LIBREhub/2_Levels_Stage/2-level-station.md

# 2-level microscopy stage

This is a variant of the Strobe-Enhanced Microscope Stage. It is still a laboratory-grade microscope for imaging fast-moving objects.



Before you start building the station you will need to source all the components listed in our [bill of materials]{BOM}.

## Instructions

These instructions will take you through how to assemble the 2-level version of the station. There is also a [3-level version](https://wenzel-lab.github.io/strobe-enhanced-microscopy-stage/) if you need a room for placing your boards and protected them in the station.

The assembly is broken up into several steps:

1. [.](printing.md){step}
1. [.](laser-cutting.md){step}
1. [.](assemble-focus-mechanism.md){step}
1. [.](basic-optics-module.md){step}
1. [.](attach-parts-to-top-plate.md){step}
1. [.](attach-parts-to-bottom-plate.md){step}
1. [.](mount-optics.md){step}
1. [.](illumination.md){step}
1. [.](wiring.md){step}
1. [.](finished.md){step}
