LIBREhub/2_Levels_Stage/info_pages/why_optics_black.html

# Strobe-Enhanced Microscopy Stage

by Pierre Padilla-Huamantinco, Matías Hurtado Labarca, and Tobias Wenzel

Latin American Hub for Bioimaging Through Open Hardware (LIBRE hub)

# Why print the optics module or lens spacer in black?

The optics module or lens spacer is used to separate the imaging optics from the camera sensor. In an ideal microscope the only light that reaches the camera sensor should be the light focused by these optics.

We can limit reflected light using black filament. This will absorb more of the stray light. Black filament is also more opaque than other filaments. This means that less light will be transmitted through the walls of the optics module.

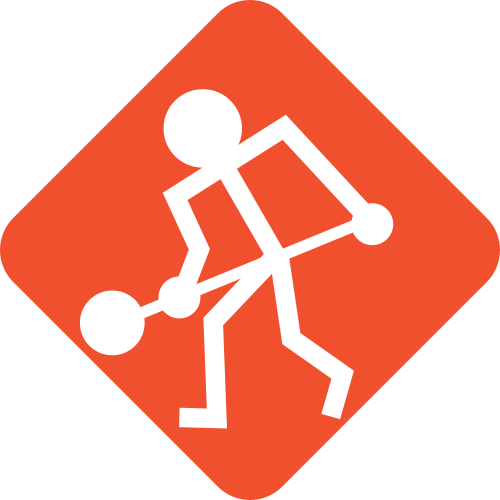
[picture p45: static/Logo/GitBuilding500x.png]
GitBuilding logo
 Documentation powered by GitBuilding (https://gitbuilding.io)

©2023 Pierre Padilla-Huamantinco, Matías Hurtado Labarca, and Tobias Wenzel

Contact: librehub@uc.cl

Strobe-Enhanced Microscopy Stage is released under CERN-OHL-1.2.
