LIBREhub/2_Levels_Stage/parts/optics/8.7-20mm-circular-lens.html

# Strobe-Enhanced Microscopy Stage

by Pierre Padilla-Huamantinco, Matías Hurtado Labarca, and Tobias Wenzel

Latin American Hub for Bioimaging Through Open Hardware (LIBRE hub)

# 8.7° 20mm Circular Beam Optics



Suppliers:

- Luxeonstar / Lens (https://www.luxeonstar.com/carclo-8.7-degree-20mm-optic)
- Luxeonstar / Holder (https://www.luxeonstar.com/carclo-20mm-round-optic-holder-black)

GitBuilding logo Documentation powered by GitBuilding (https://gitbuilding.io)

©2023 Pierre Padilla-Huamantinco, Matías Hurtado Labarca, and Tobias Wenzel

Contact: librehub@uc.cl

Strobe-Enhanced Microscopy Stage is released under CERN-OHL-1.2.
