LIBREhub/2_Levels_Stage/images/bottom_plate_to_focus_1.jpg

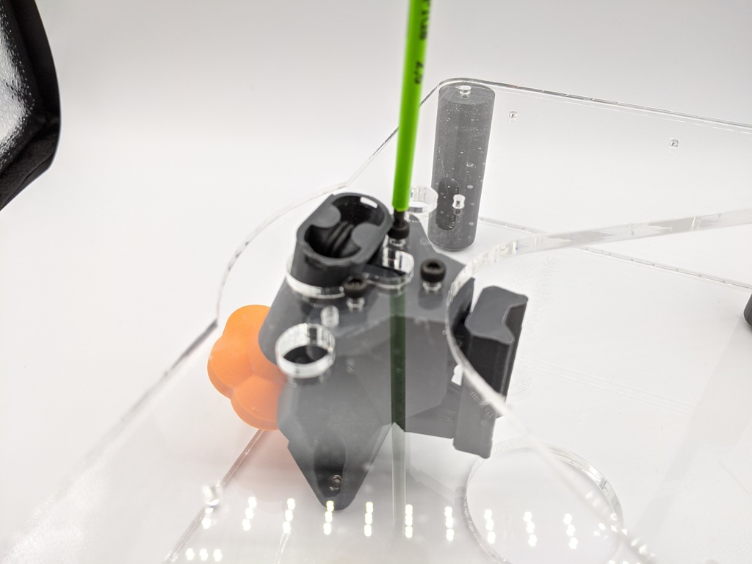
images/bottom_plate_to_focus_1.jpg
