LIBREhub/2_Levels_Stage/images/bottom_plate_to_focus_2.jpg

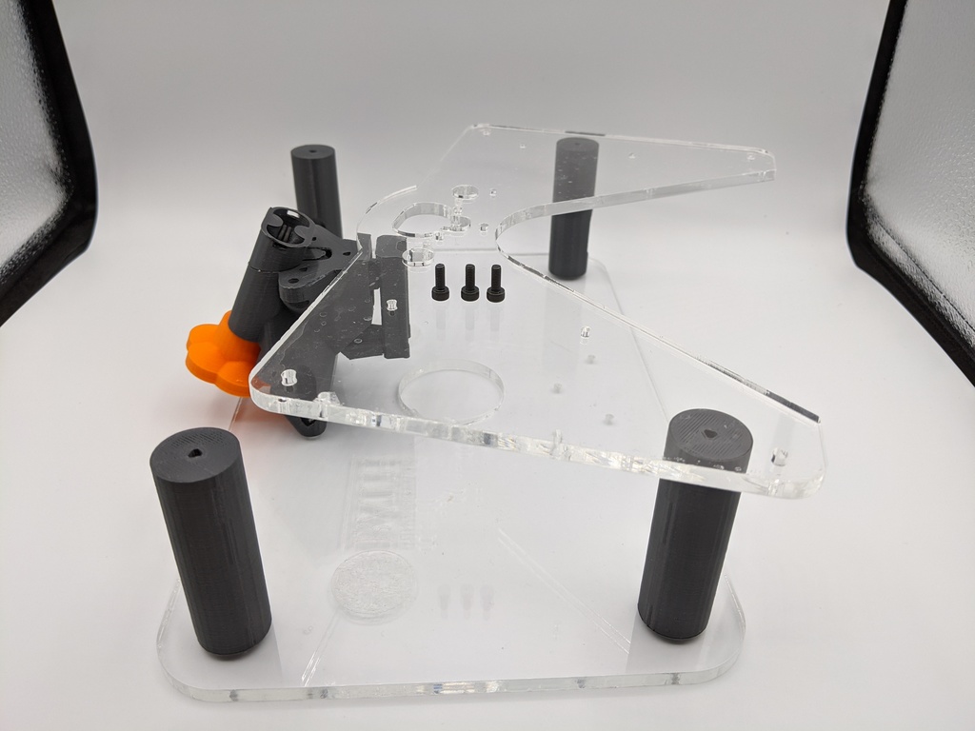
images/bottom_plate_to_focus_2.jpg
