LIBREhub/2_Levels_Stage/images/BrimRemoval.png

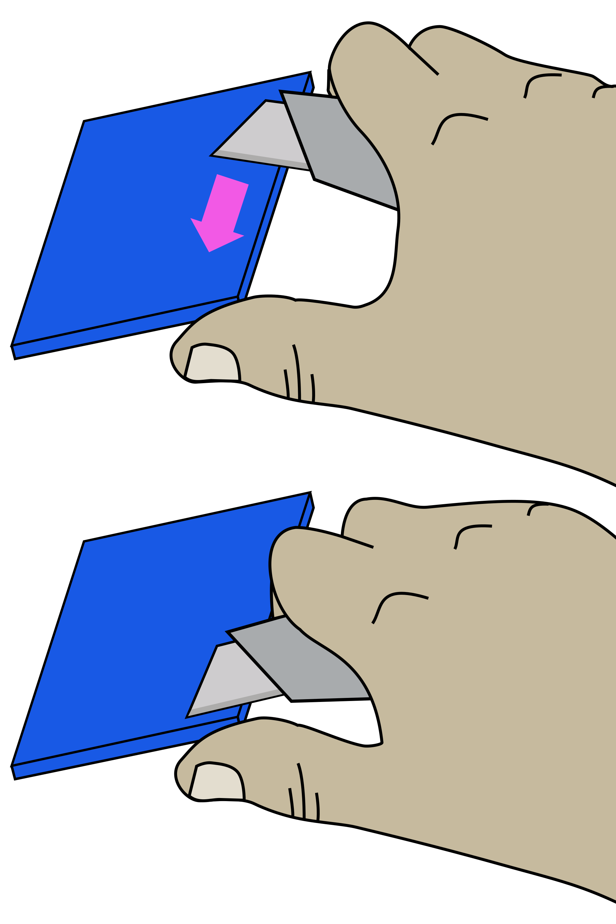
images/BrimRemoval.png
