LIBREhub/2_Levels_Stage/images/cap.jpg

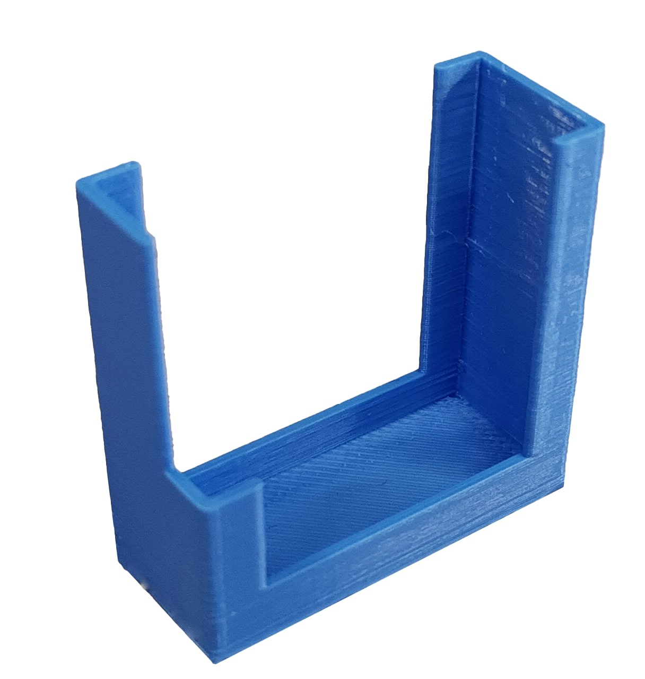
images/cap.jpg
