LIBREhub/2_Levels_Stage/images/Crimper.jpg

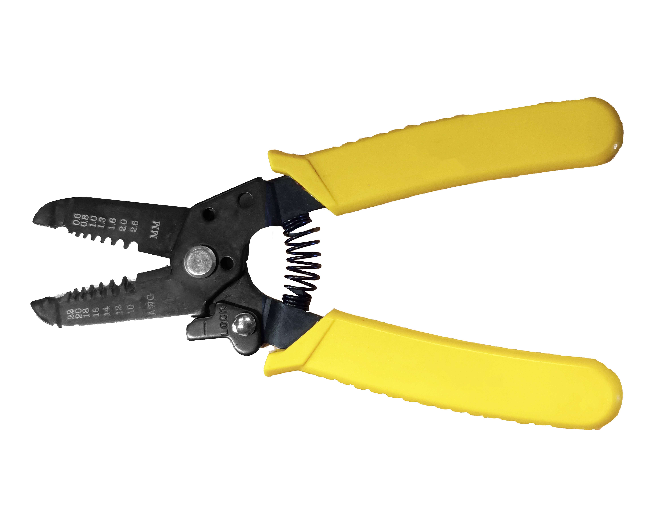
images/Crimper.jpg
