LIBREhub/2_Levels_Stage/images/dupont-housing.jpg

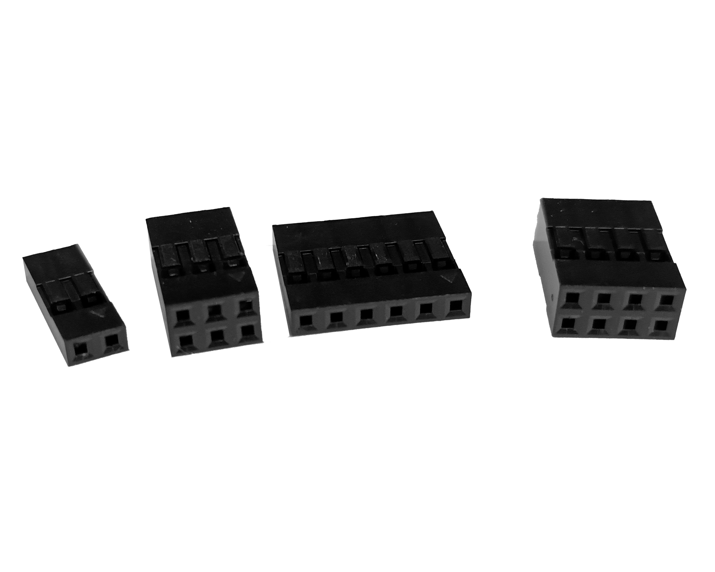
images/dupont-housing.jpg
