LIBREhub/2_Levels_Stage/images/feet-M-attached.jpg

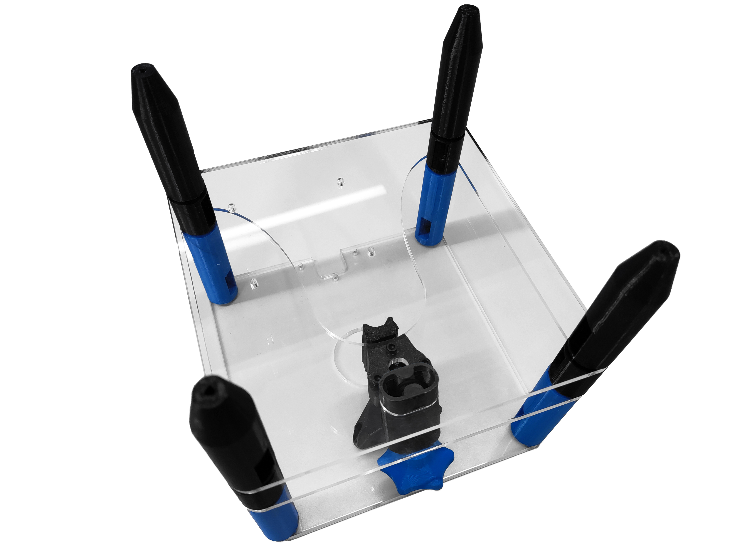
images/feet-M-attached.jpg
