LIBREhub/2_Levels_Stage/images/feet-M-attached_1.jpg

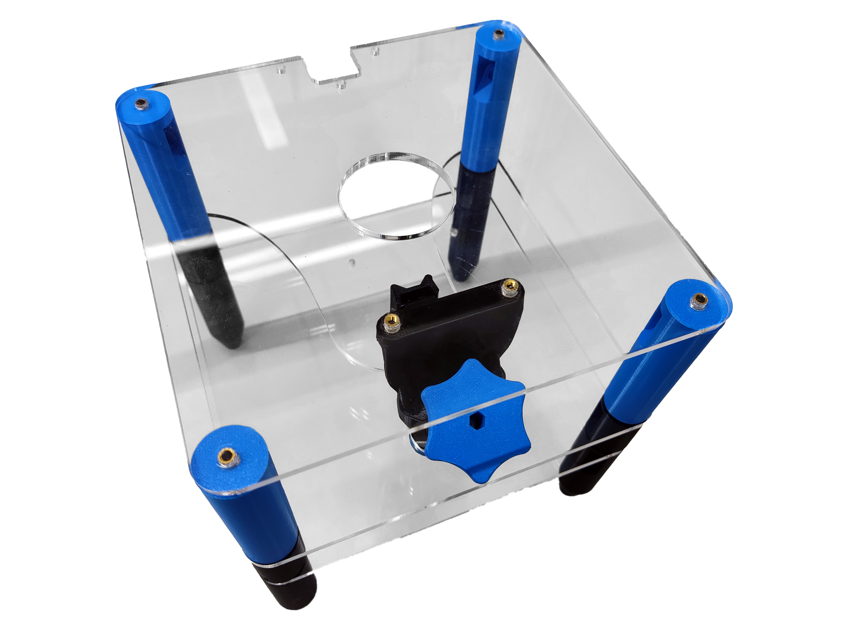
images/feet-M-attached_1.jpg
