LIBREhub/2_Levels_Stage/images/feet_attachment.png

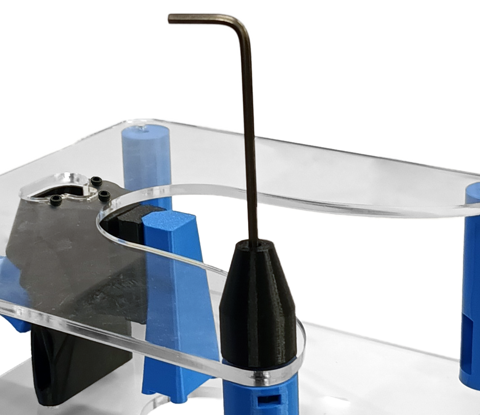
images/feet_attachment.png
