LIBREhub/2_Levels_Stage/images/Female-crimp-pin.jpg

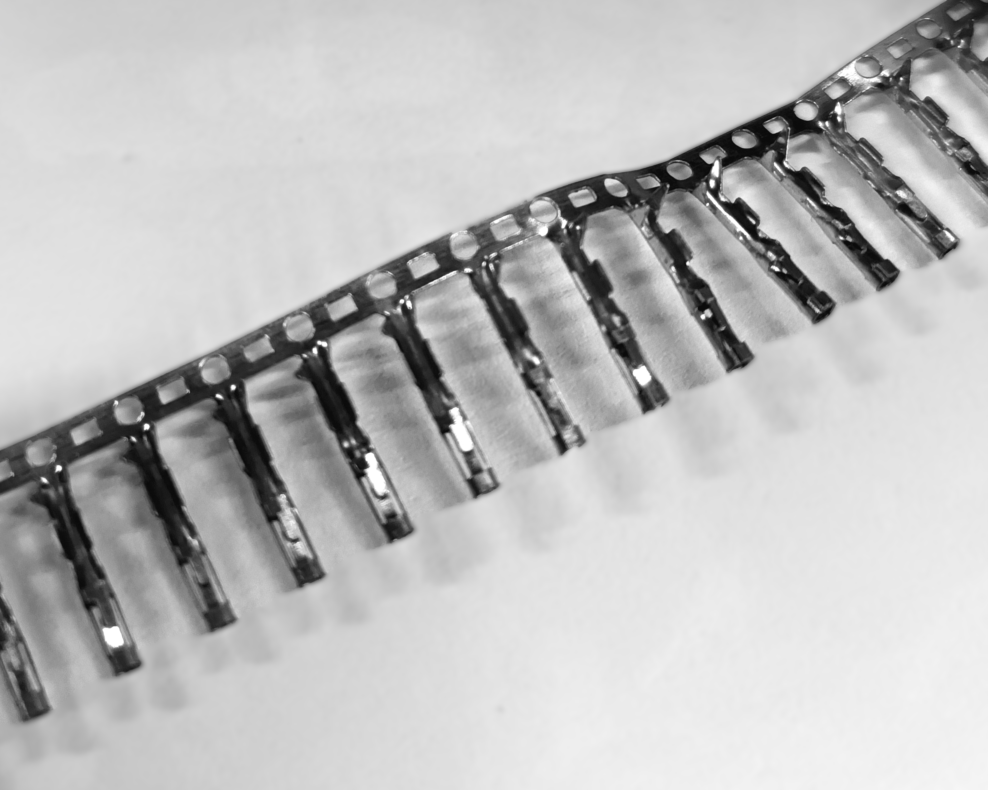
images/Female-crimp-pin.jpg
