LIBREhub/2_Levels_Stage/images/foot-M-attached.jpg

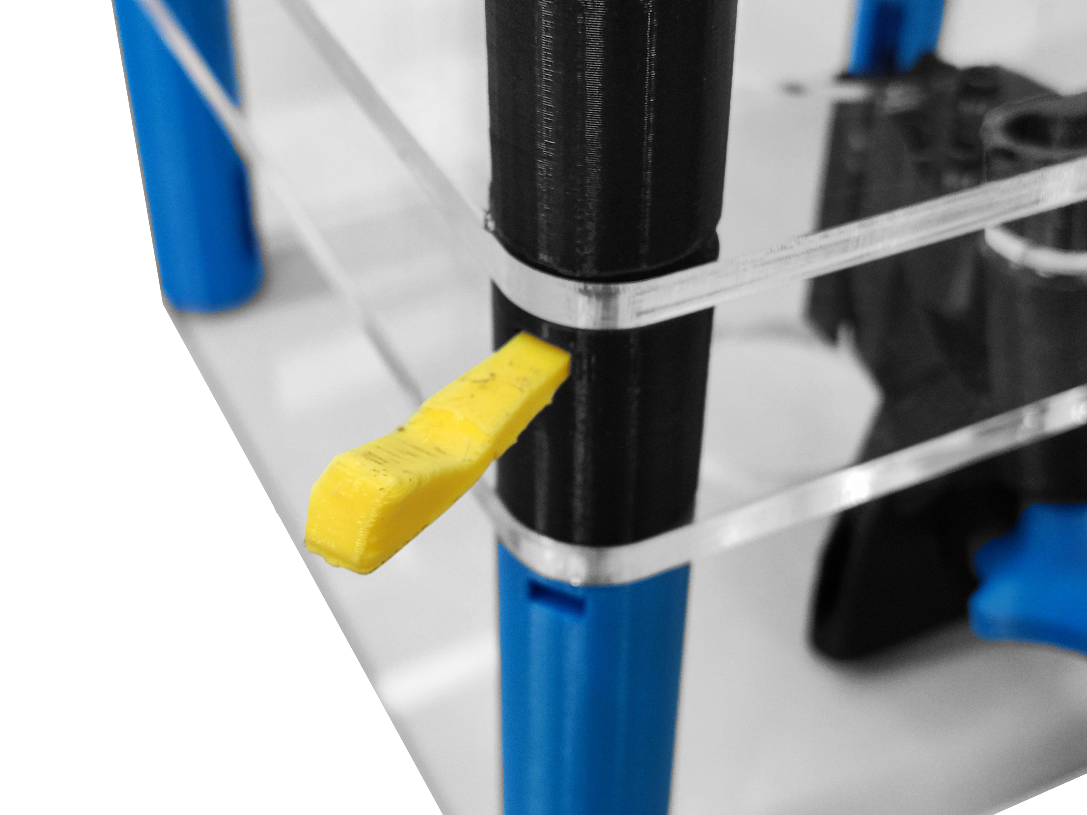
images/foot-M-attached.jpg
