LIBREhub/2_Levels_Stage/images/heat-insert_top-plate_2.png

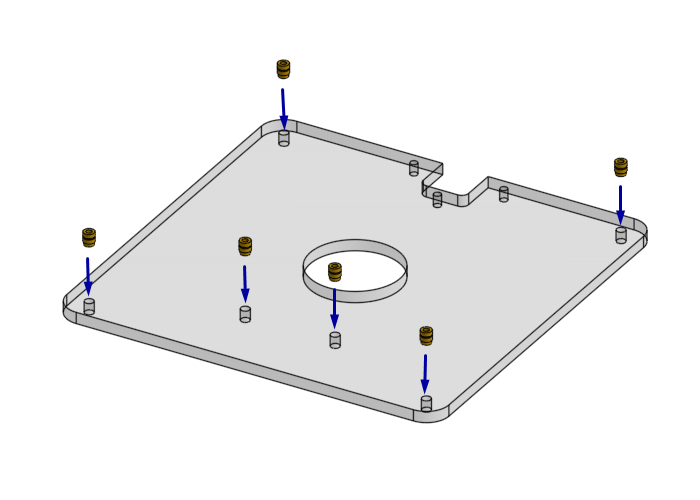
images/heat-insert_top-plate_2.png
