LIBREhub/2_Levels_Stage/images/heat-sink.jpg

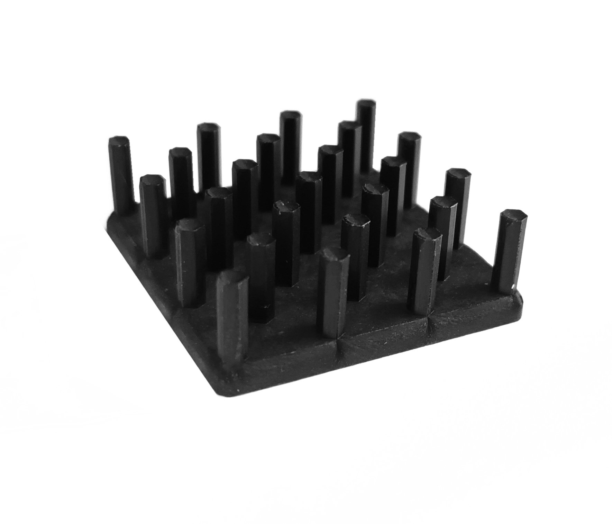
images/heat-sink.jpg
