LIBREhub/2_Levels_Stage/images/Hinsert.jpg

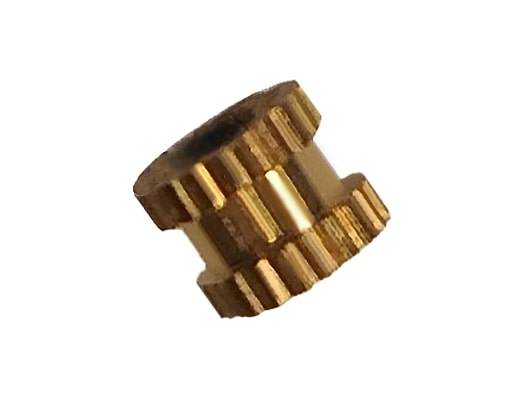
images/Hinsert.jpg
