LIBREhub/2_Levels_Stage/images/iii.jpg

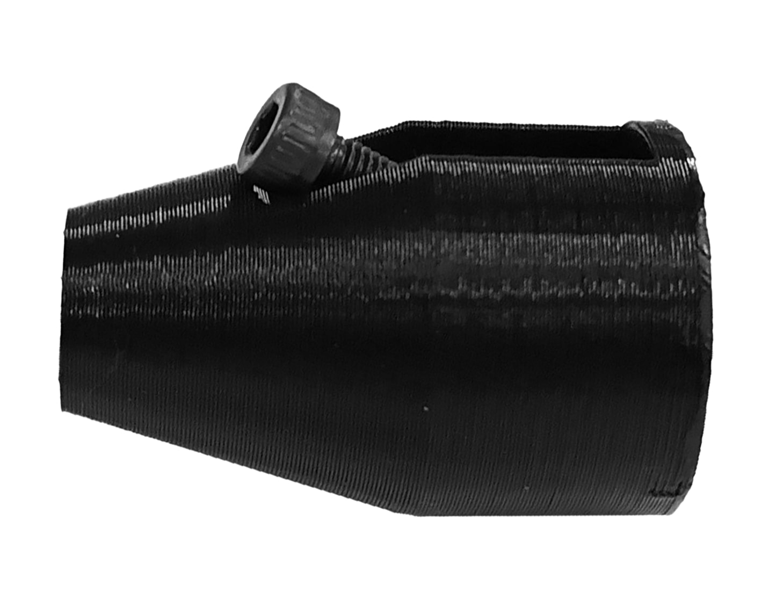
images/iii.jpg
