LIBREhub/2_Levels_Stage/images/jack-connector.jpg

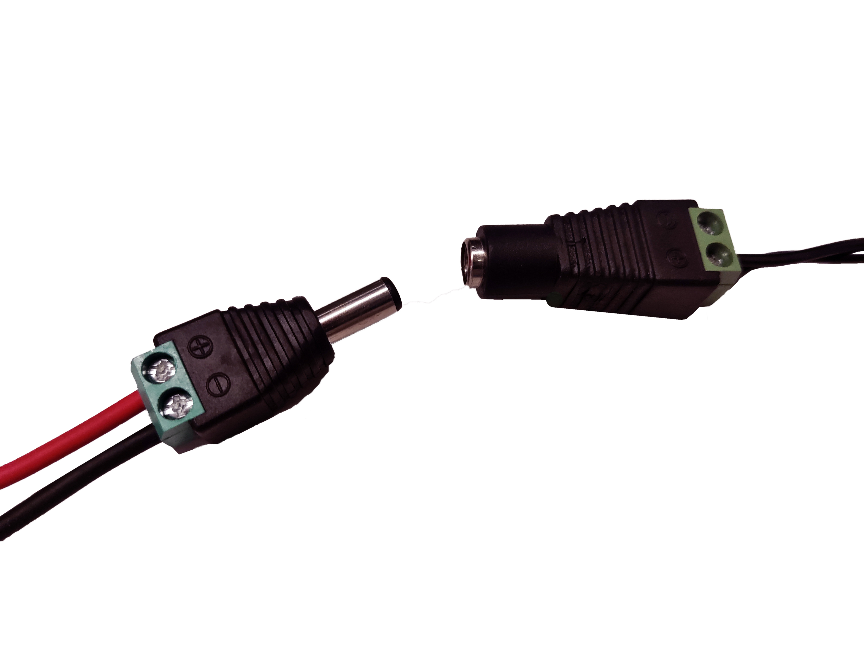
images/jack-connector.jpg
