LIBREhub/2_Levels_Stage/images/knob.jpg

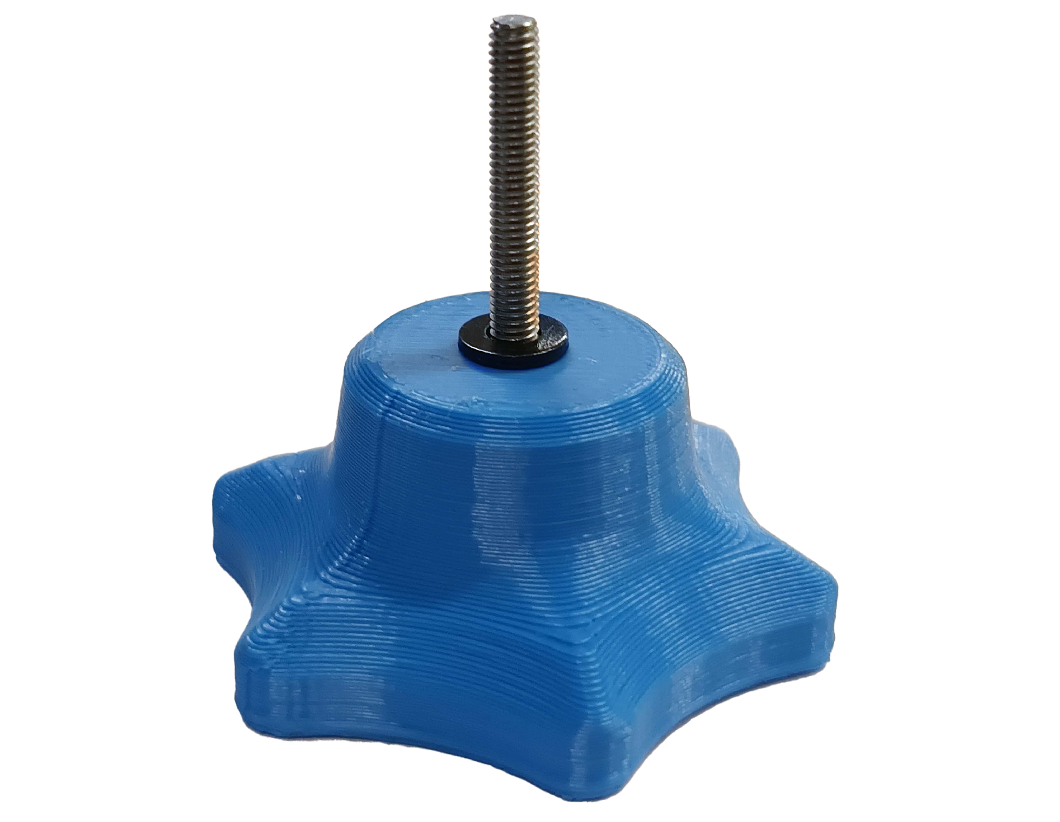
images/knob.jpg
