LIBREhub/2_Levels_Stage/images/led-lens-sink.png

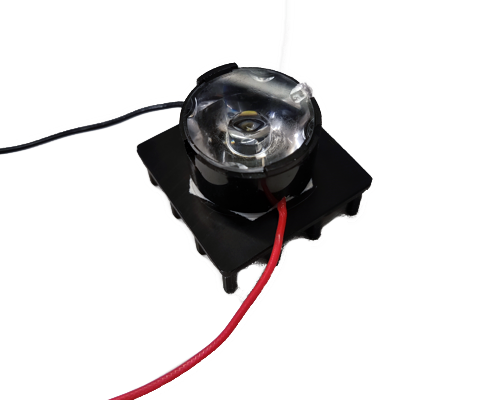
images/led-lens-sink.png
