LIBREhub/2_Levels_Stage/images/LH-Hinsert.jpg

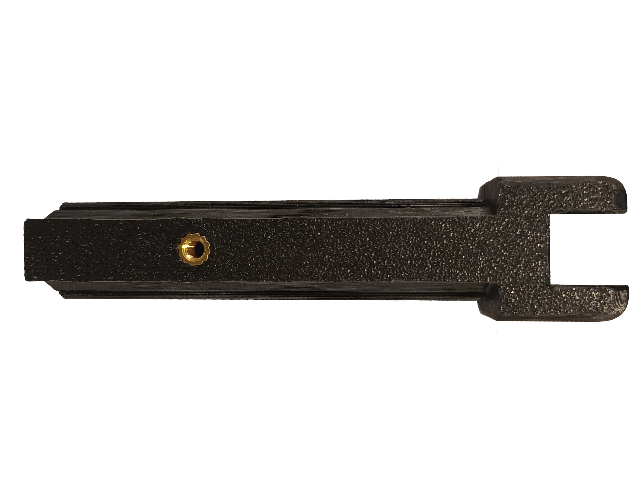
images/LH-Hinsert.jpg
