LIBREhub/2_Levels_Stage/images/LH-knob.jpg

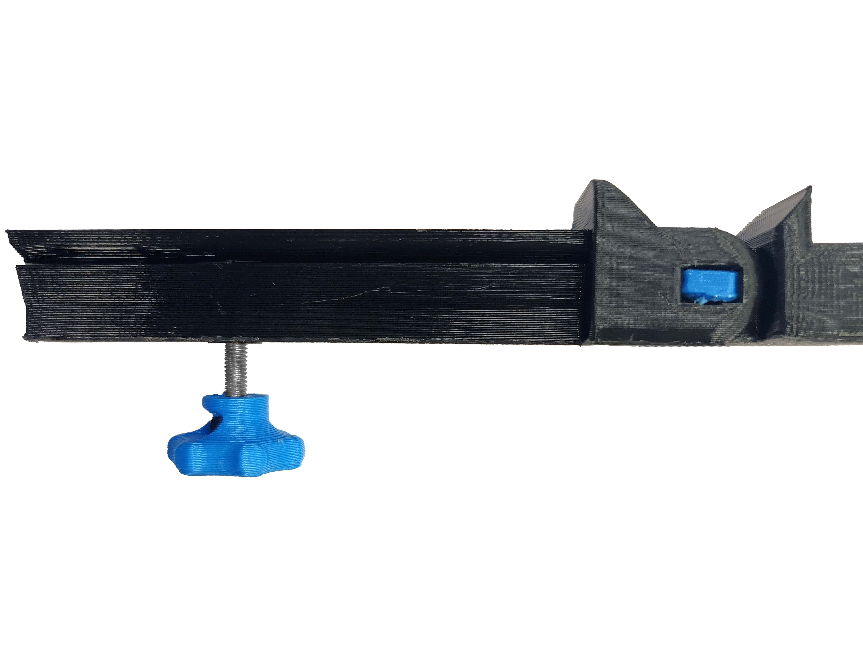
images/LH-knob.jpg
