LIBREhub/2_Levels_Stage/images/LH-pin.jpg

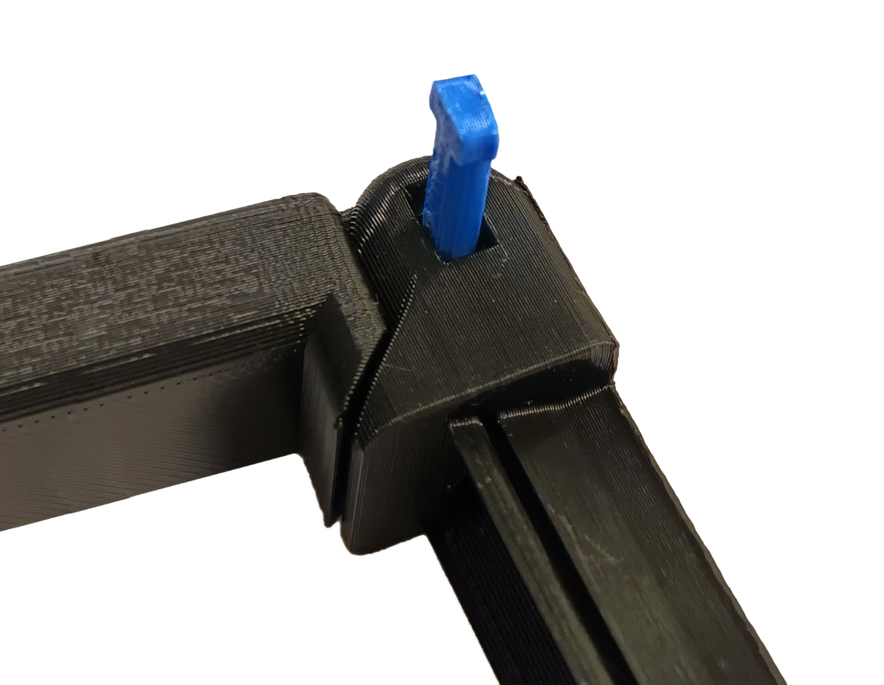
images/LH-pin.jpg
