LIBREhub/2_Levels_Stage/images/light-led.jpg

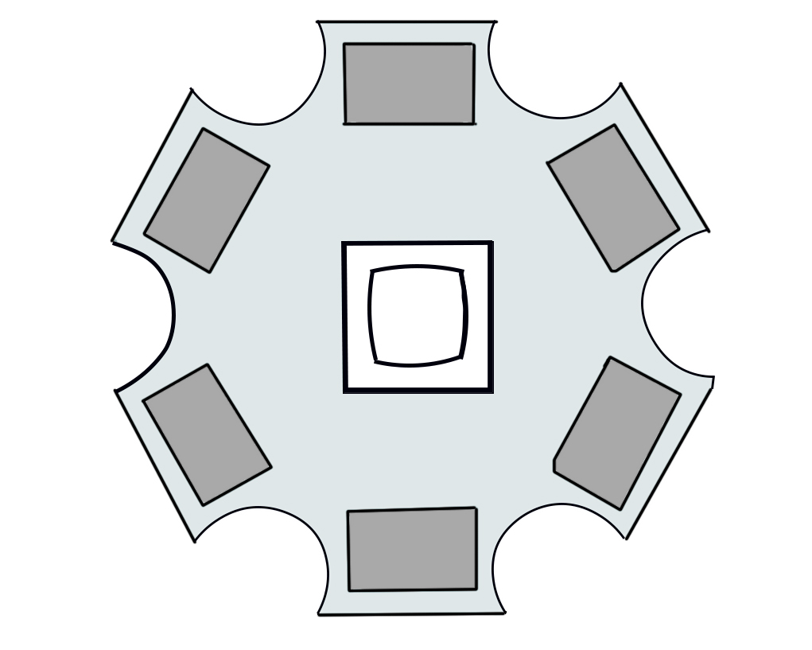
images/light-led.jpg
