LIBREhub/2_Levels_Stage/images/Male-crimp-pin.jpg

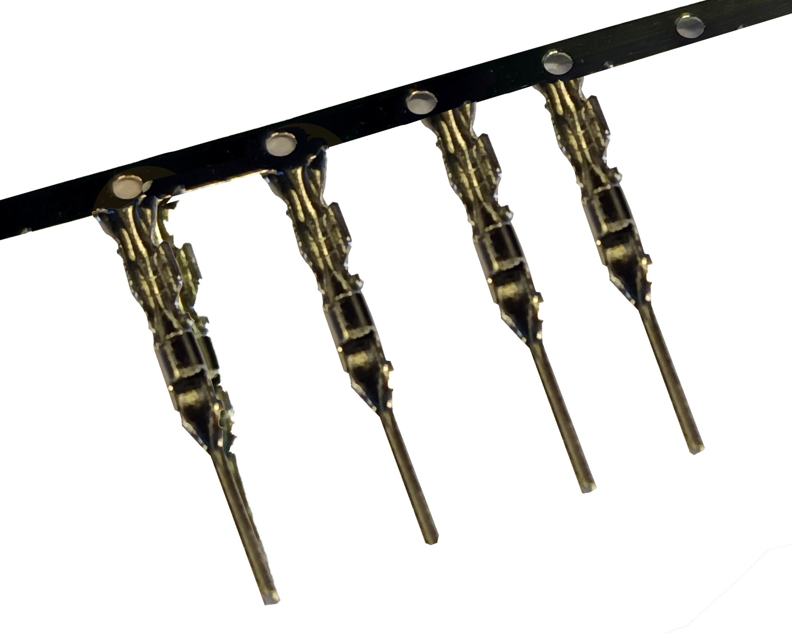
images/Male-crimp-pin.jpg
