LIBREhub/2_Levels_Stage/images/mount_spacers.jpg

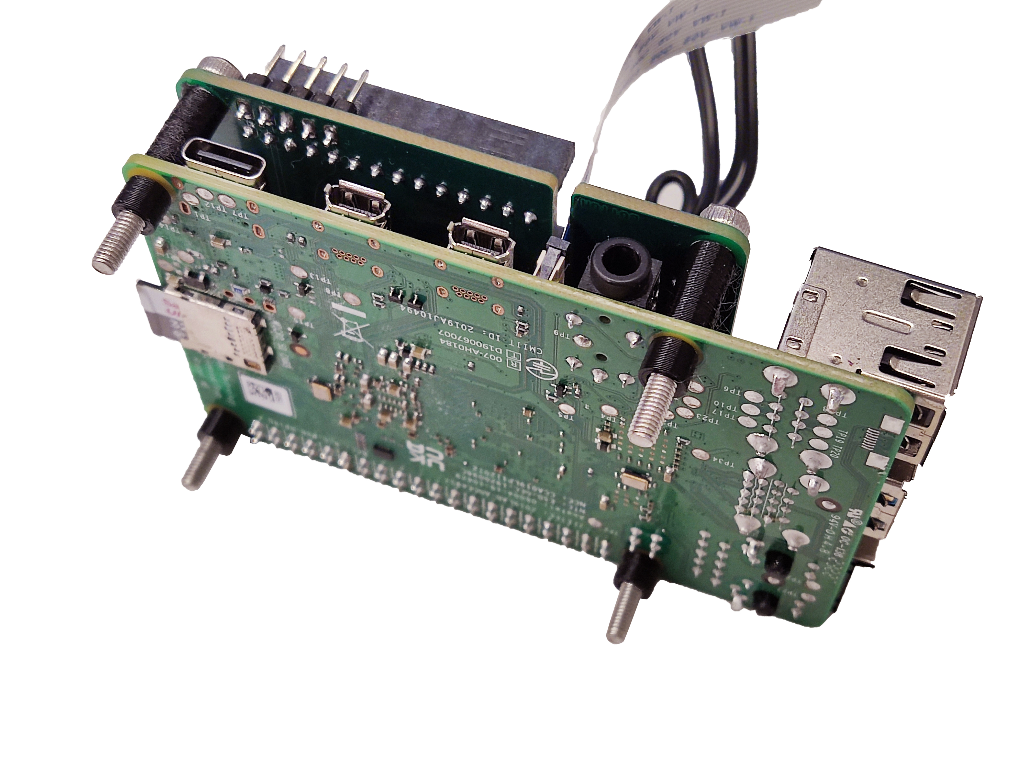
images/mount_spacers.jpg
