LIBREhub/2_Levels_Stage/images/nitrile-glove.jpg

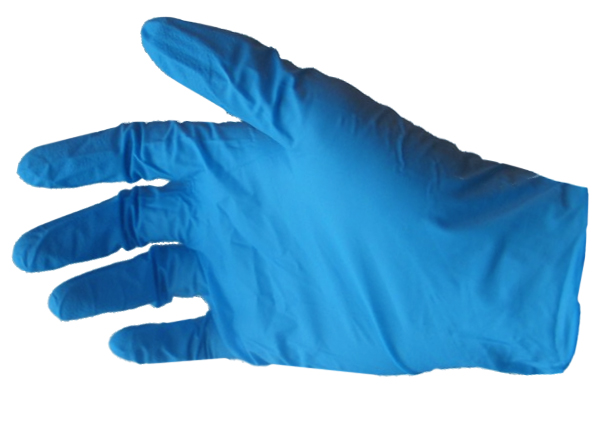
images/nitrile-glove.jpg
