LIBREhub/2_Levels_Stage/images/nutpushers.jpg

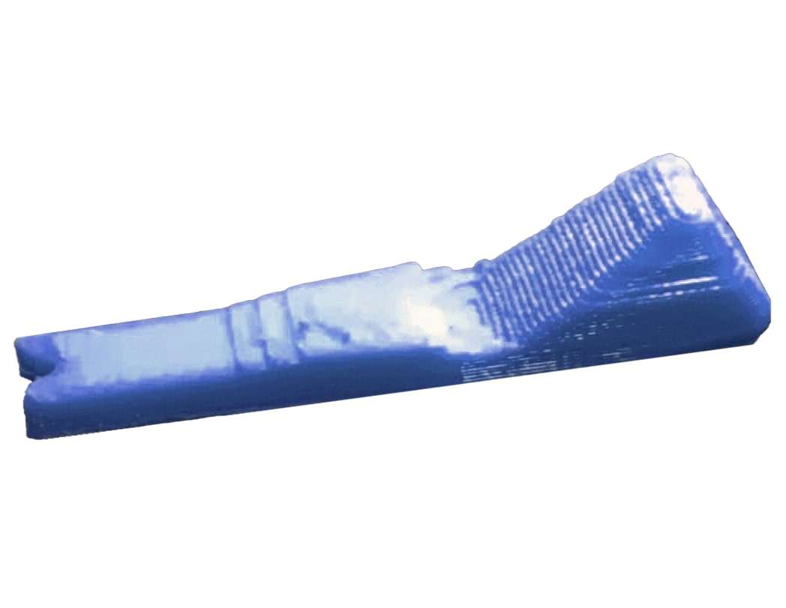
images/nutpushers.jpg
