LIBREhub/2_Levels_Stage/images/partelight.jpg

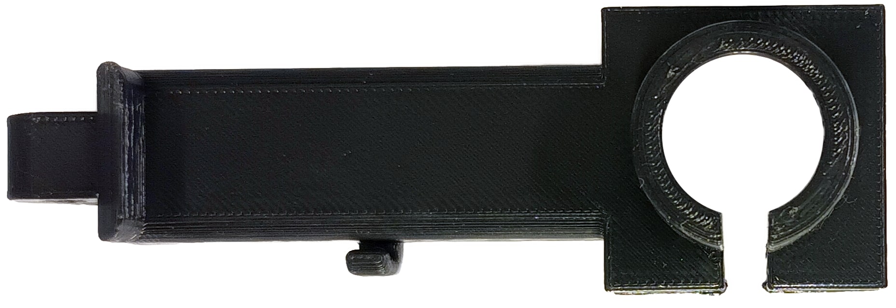
images/partelight.jpg
