LIBREhub/2_Levels_Stage/images/partelighthold.jpg

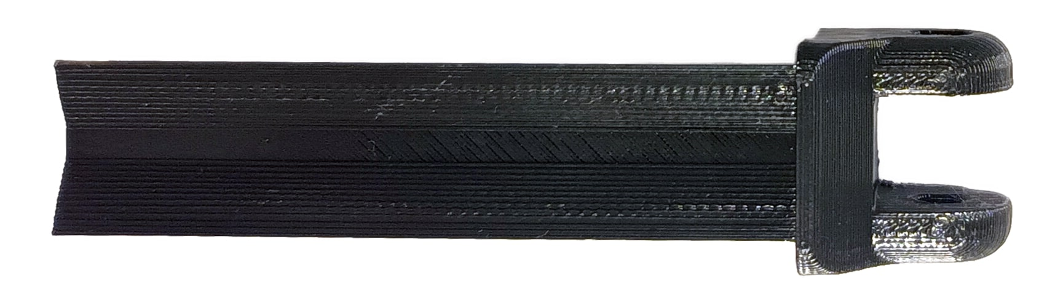
images/partelighthold.jpg
