LIBREhub/2_Levels_Stage/images/partelightholder.jpg

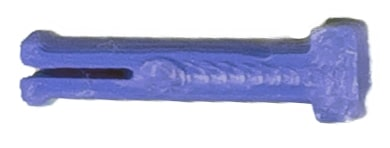
images/partelightholder.jpg
