LIBREhub/2_Levels_Stage/images/pi-charger.jpg

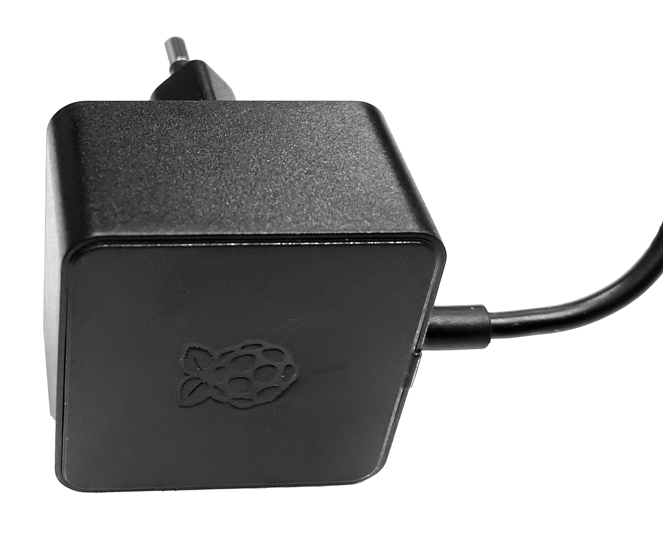
images/pi-charger.jpg
