LIBREhub/2_Levels_Stage/images/PI-hat.jpg

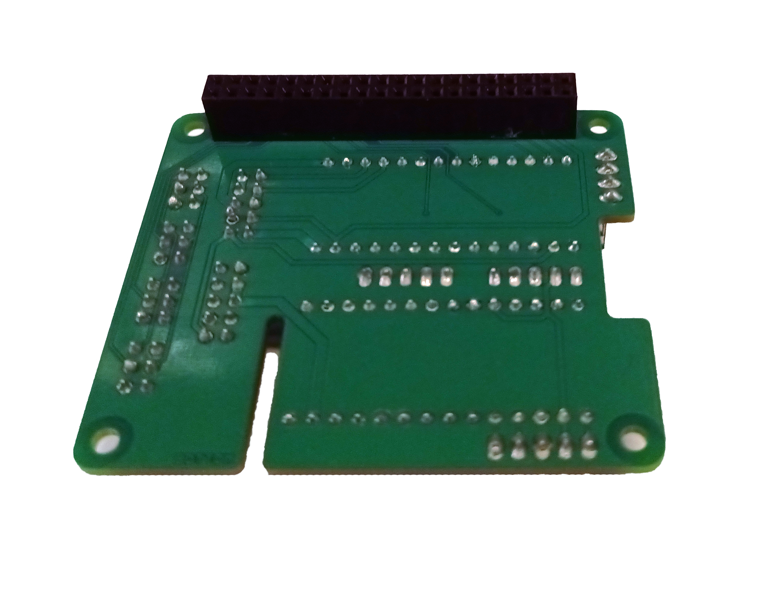
images/PI-hat.jpg
