LIBREhub/2_Levels_Stage/images/picamlt.jpg

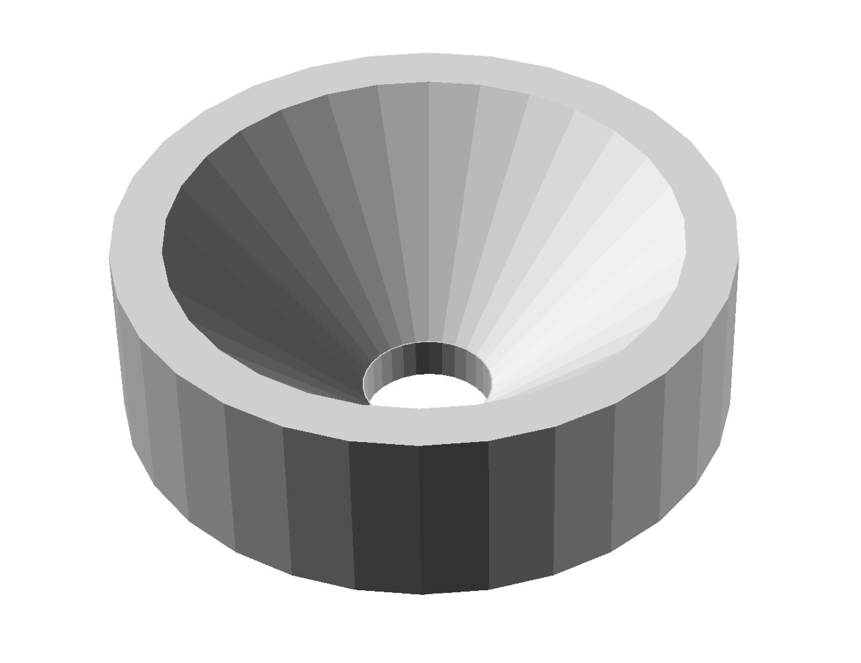
images/picamlt.jpg
