LIBREhub/2_Levels_Stage/images/picamv.jpg

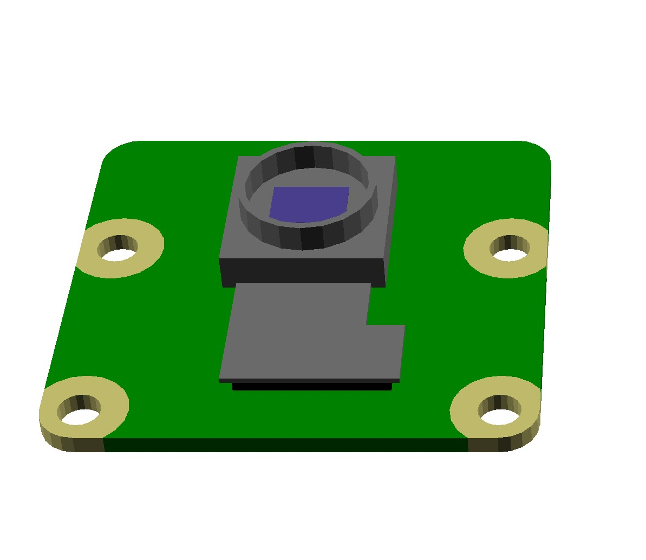
images/picamv.jpg
