LIBREhub/2_Levels_Stage/images/pliersLCC.jpg

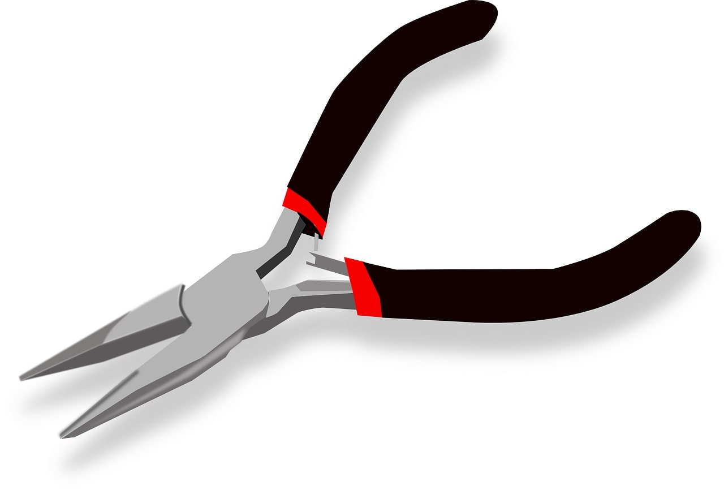
images/pliersLCC.jpg
