LIBREhub/2_Levels_Stage/images/Precision-wire-cutters.jpg

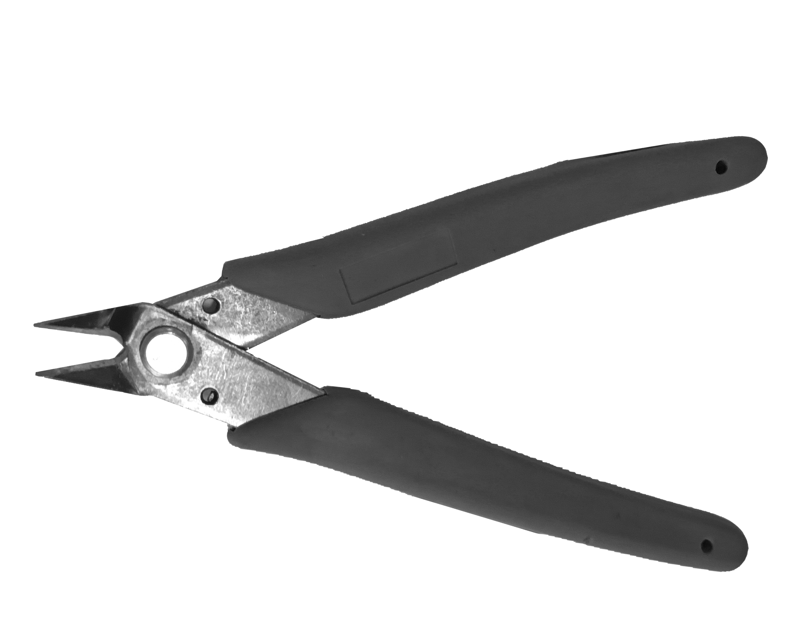
images/Precision-wire-cutters.jpg
