LIBREhub/2_Levels_Stage/images/prepare-electronics.jpg

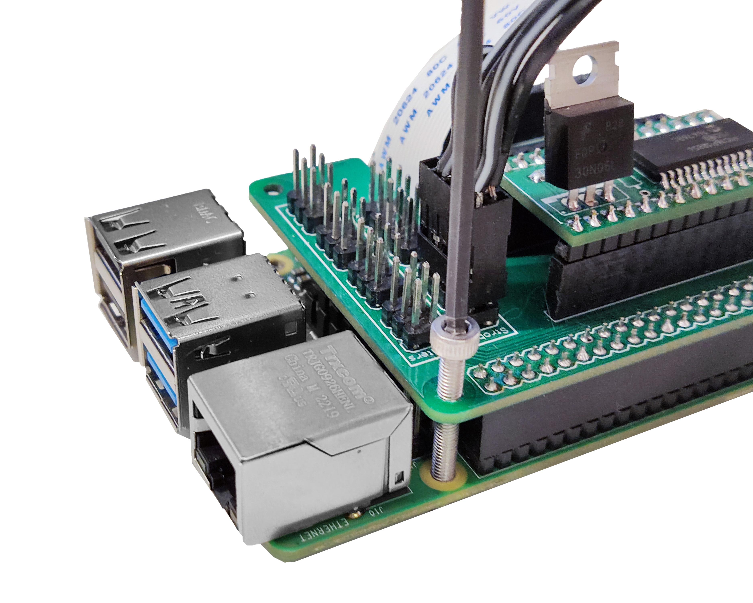
images/prepare-electronics.jpg
