LIBREhub/2_Levels_Stage/images/prepare-electronics_1.jpg

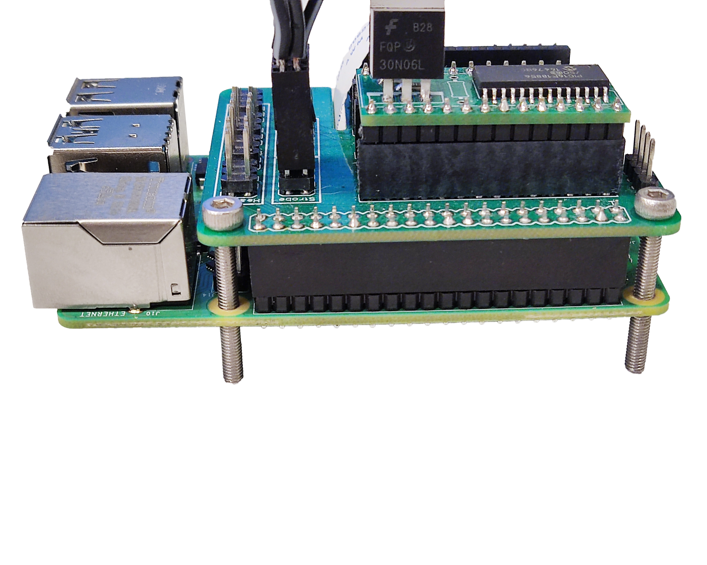
images/prepare-electronics_1.jpg
