LIBREhub/2_Levels_Stage/images/prepare-electronics_3.jpg

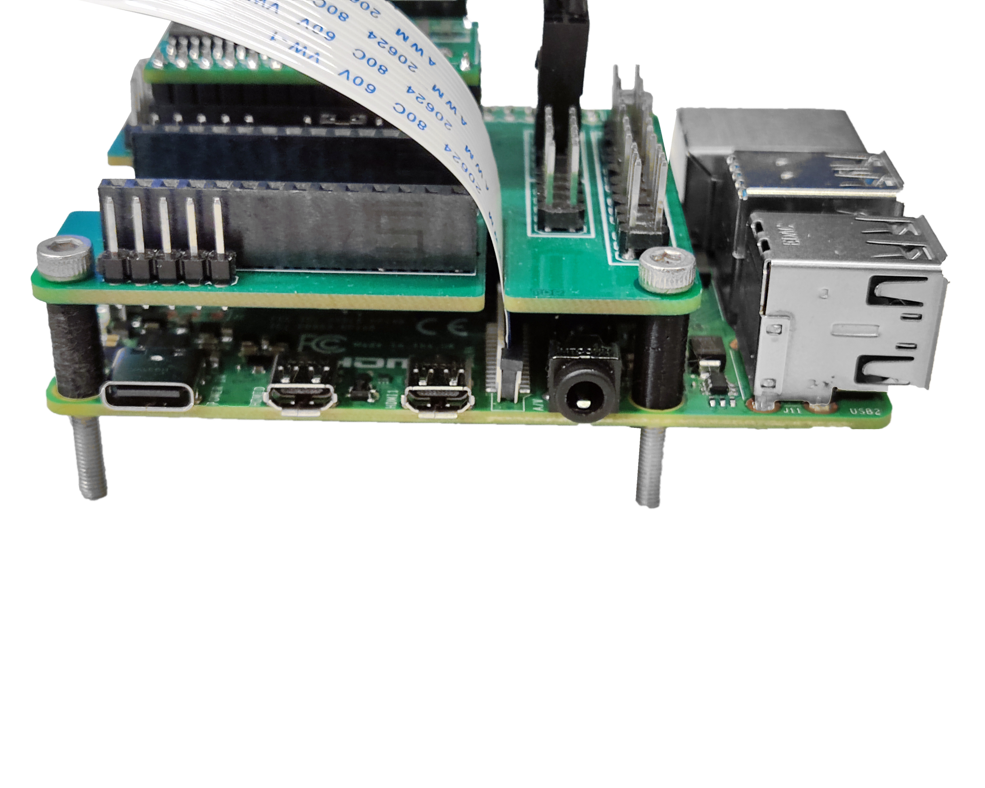
images/prepare-electronics_3.jpg
