LIBREhub/2_Levels_Stage/images/pumps.jpg

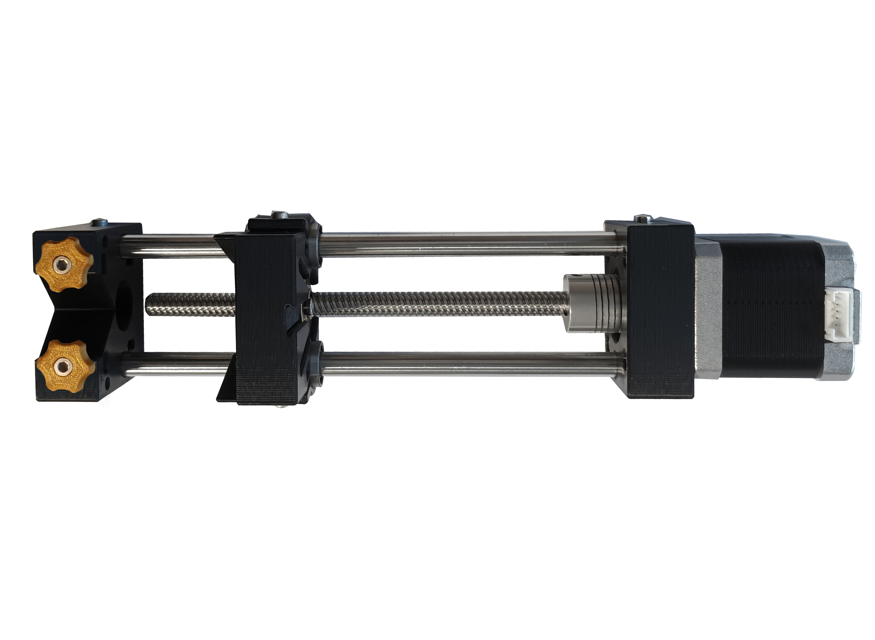
images/pumps.jpg
