LIBREhub/2_Levels_Stage/images/screen.jpg

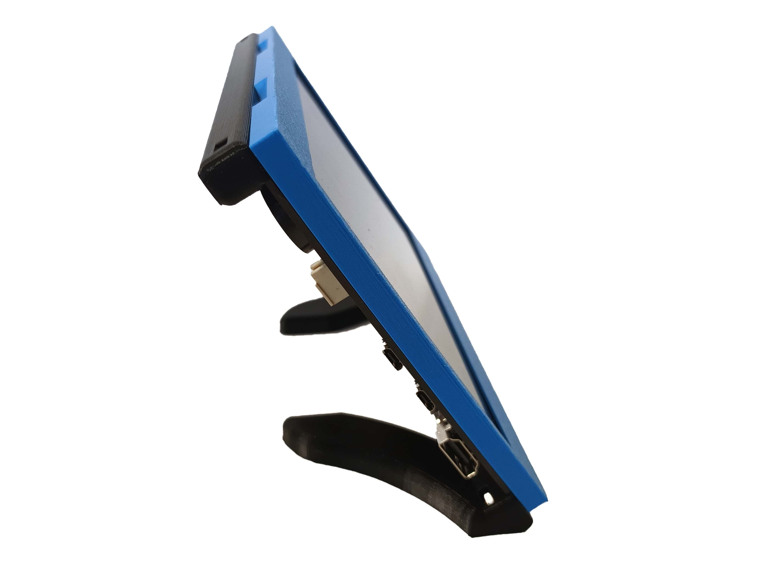
images/screen.jpg
