LIBREhub/2_Levels_Stage/images/screens.jpg

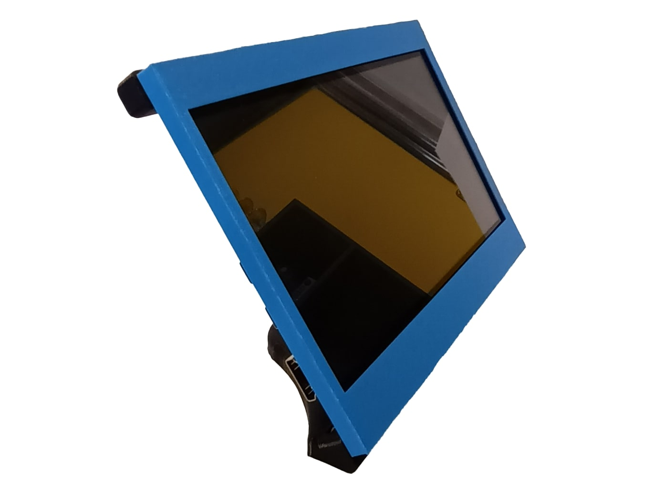
images/screens.jpg
