LIBREhub/2_Levels_Stage/images/screw.jpg

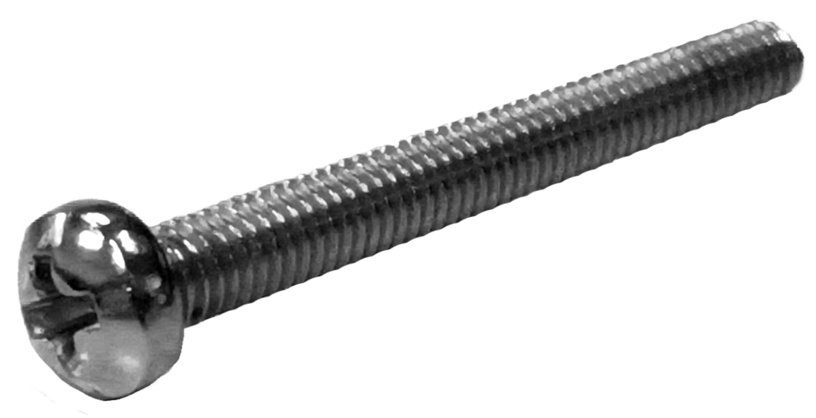
images/screw.jpg
