LIBREhub/2_Levels_Stage/images/screwdriver.jpg

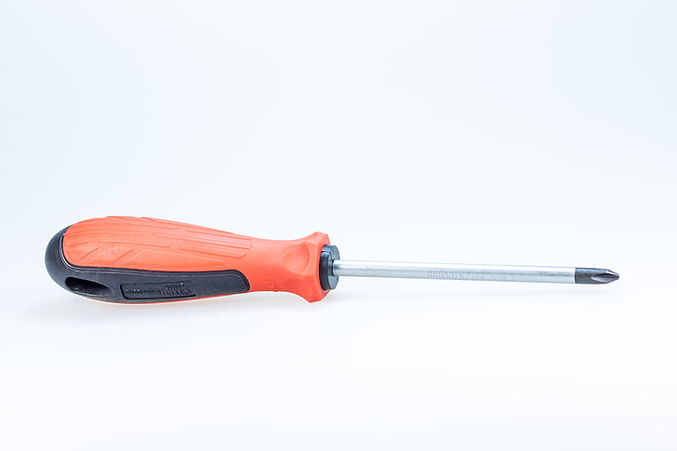
images/screwdriver.jpg
