LIBREhub/2_Levels_Stage/images/silde-knob.jpg

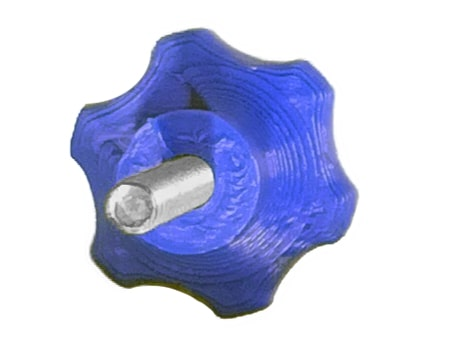
images/silde-knob.jpg
