LIBREhub/2_Levels_Stage/images/spacer-top-flip.jpg

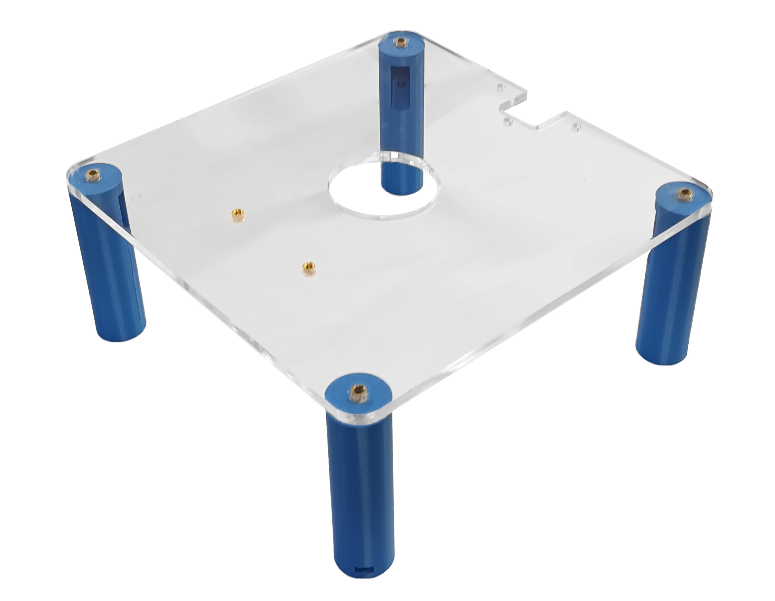
images/spacer-top-flip.jpg
