LIBREhub/2_Levels_Stage/images/strobe-module1.jpg

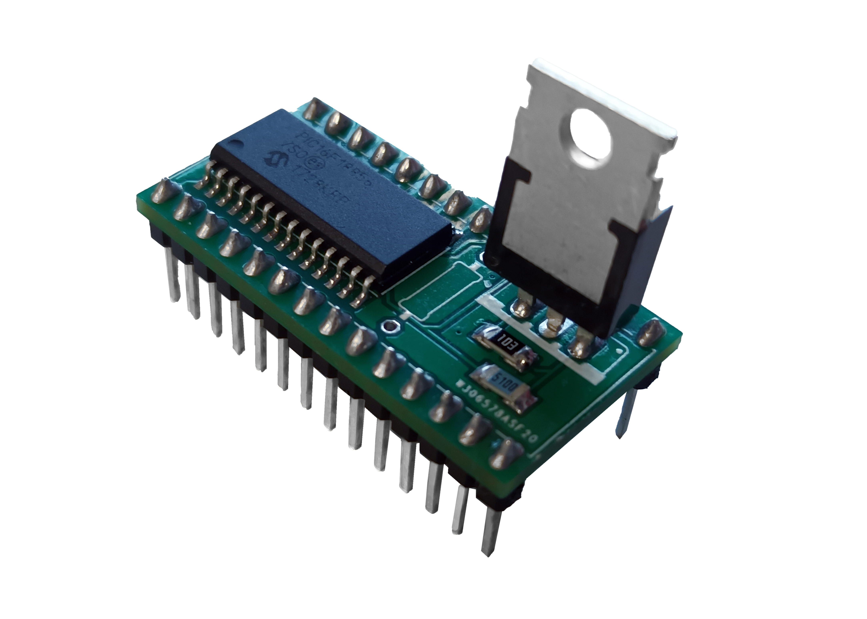
images/strobe-module1.jpg
