LIBREhub/2_Levels_Stage/images/strobe-module2.jpg

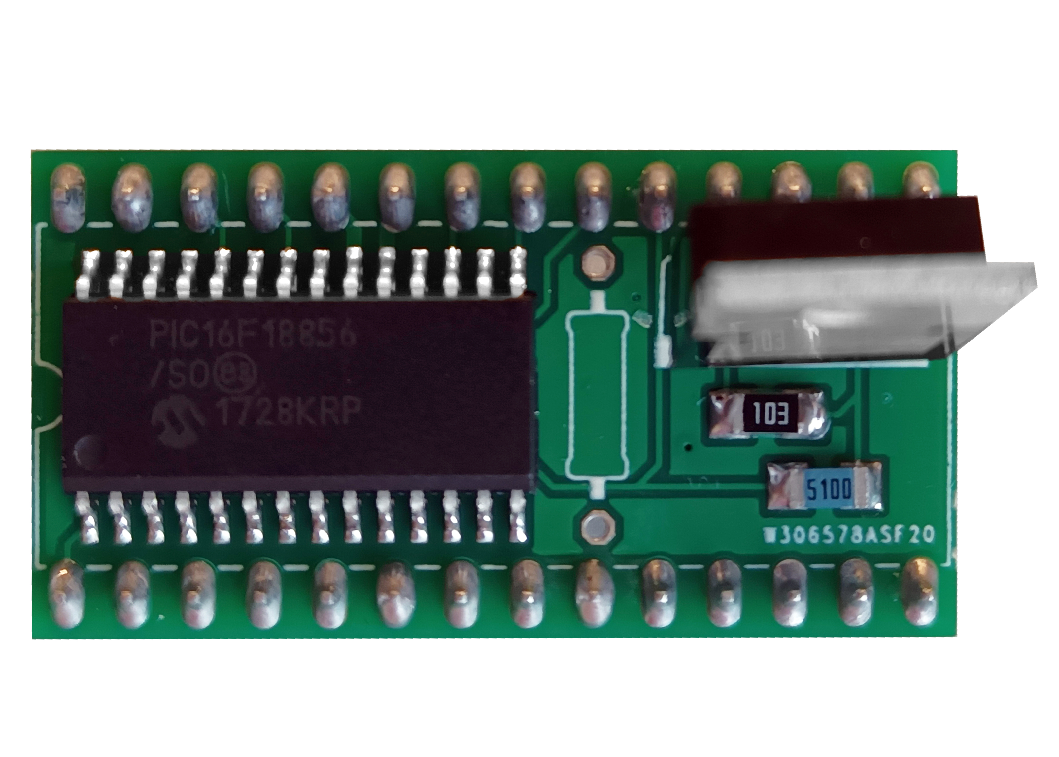
images/strobe-module2.jpg
