LIBREhub/2_Levels_Stage/images/strobe-module.jpg

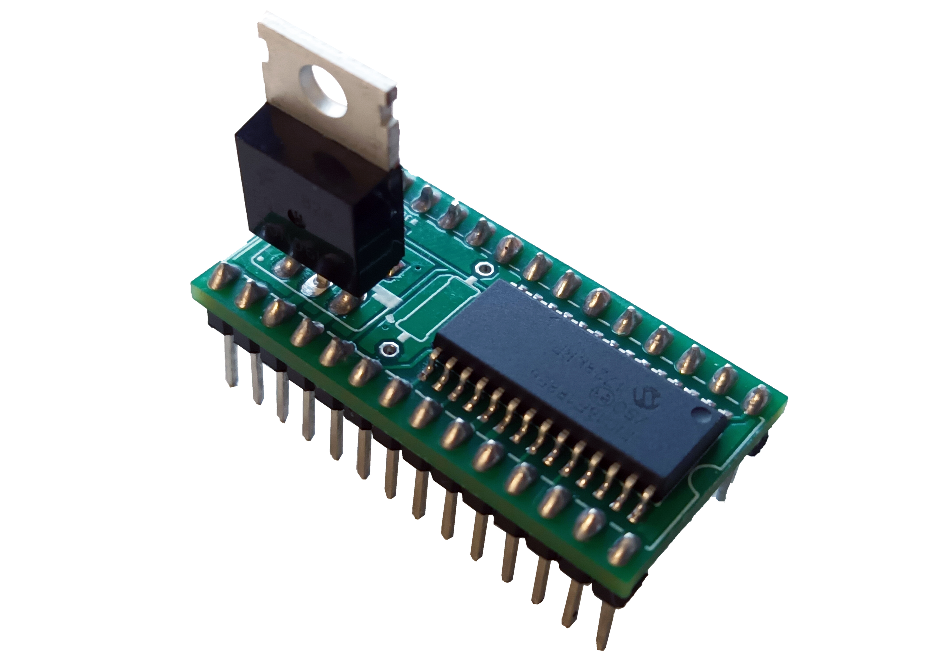
images/strobe-module.jpg
