LIBREhub/2_Levels_Stage/images/Strobe-power-supply.jpg

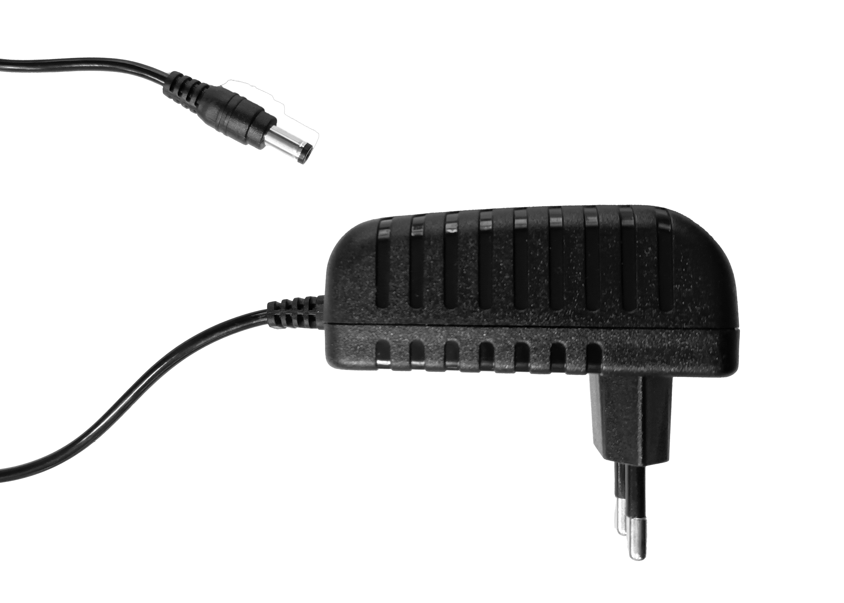
images/Strobe-power-supply.jpg
