LIBREhub/2_Levels_Stage/images/Strobe-power-supplys.jpg

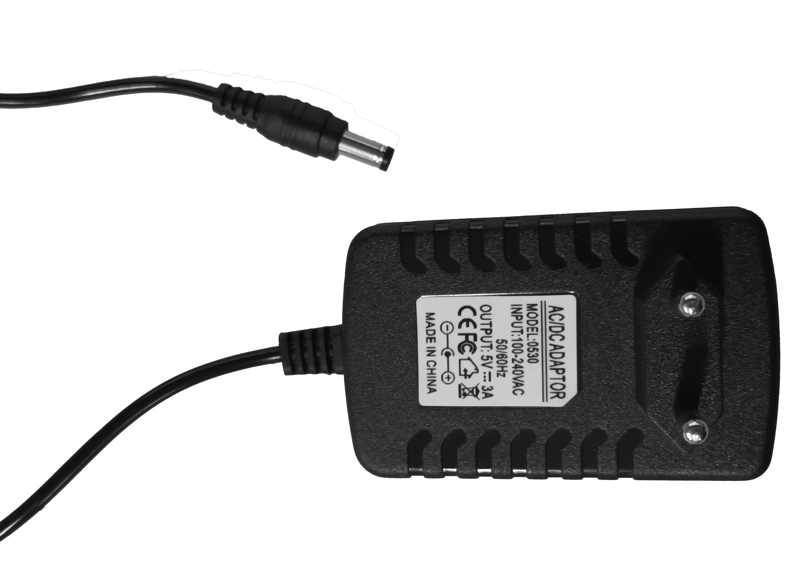
images/Strobe-power-supplys.jpg
