LIBREhub/2_Levels_Stage/images/tap_bottom_plate.jpg

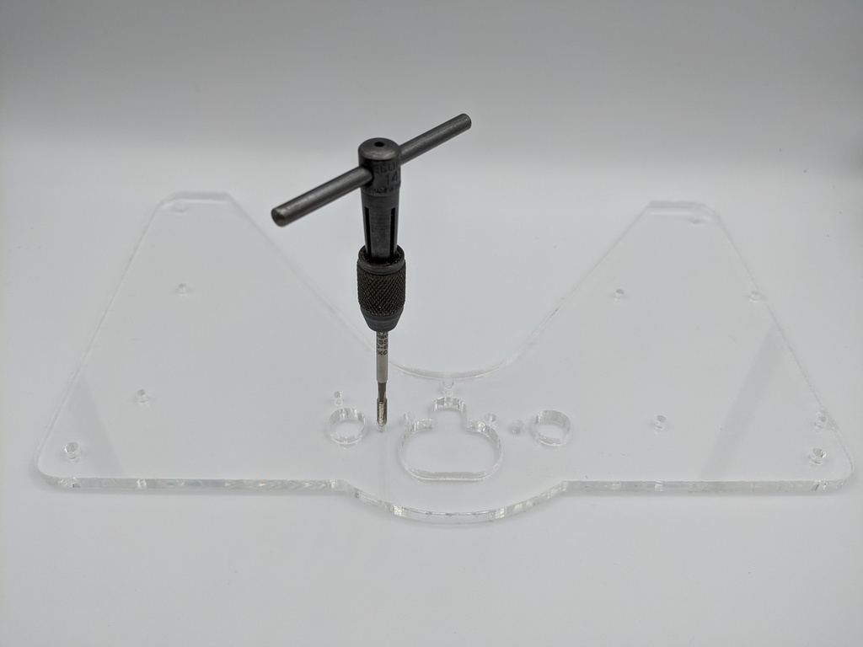
images/tap_bottom_plate.jpg
