LIBREhub/2_Levels_Stage/images/tap_top_plate_1.jpg

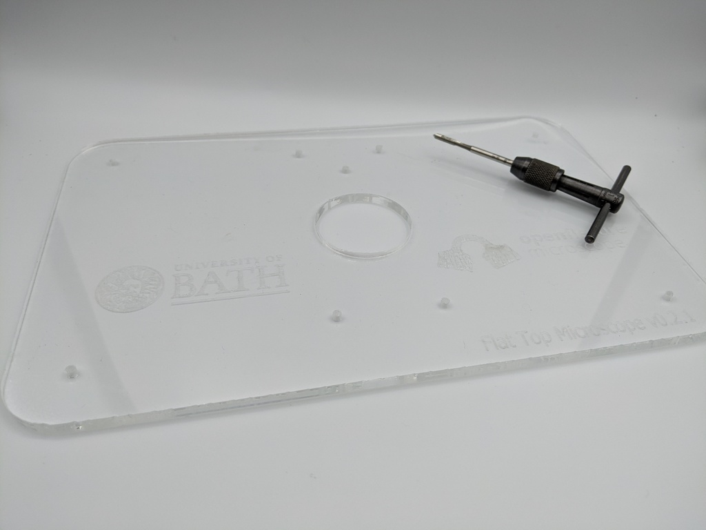
images/tap_top_plate_1.jpg
