LIBREhub/2_Levels_Stage/images/tap_top_plate_2.jpg

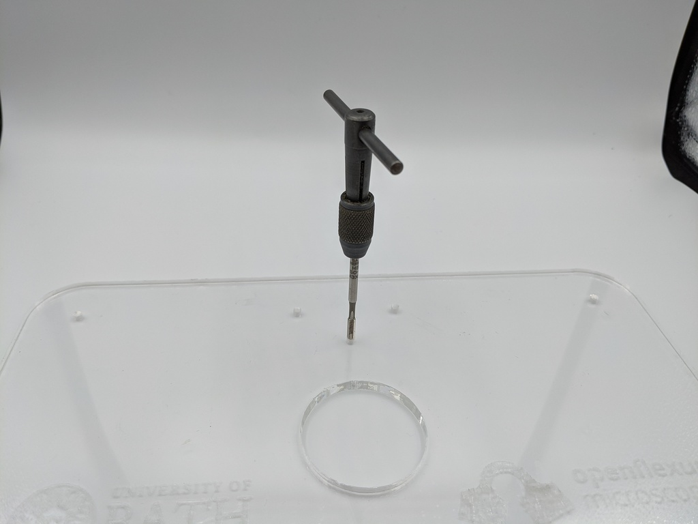
images/tap_top_plate_2.jpg
