LIBREhub/2_Levels_Stage/images/thumbscrew-slider.png

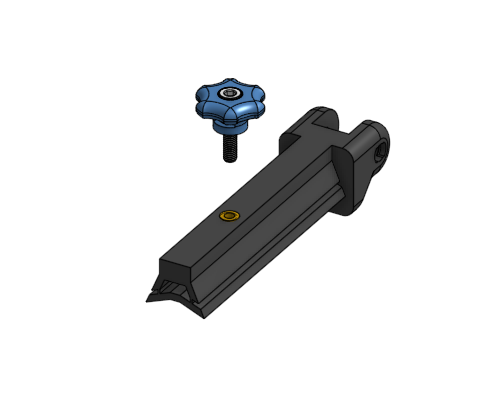
images/thumbscrew-slider.png
