LIBREhub/2_Levels_Stage/images/thumbwheel_lubricate.jpg

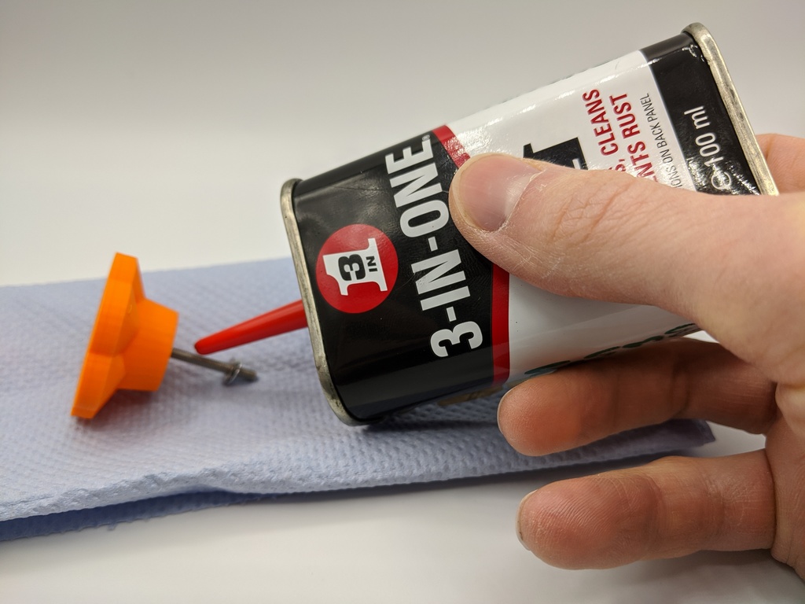
images/thumbwheel_lubricate.jpg
