LIBREhub/2_Levels_Stage/images/Tweezers.jpg

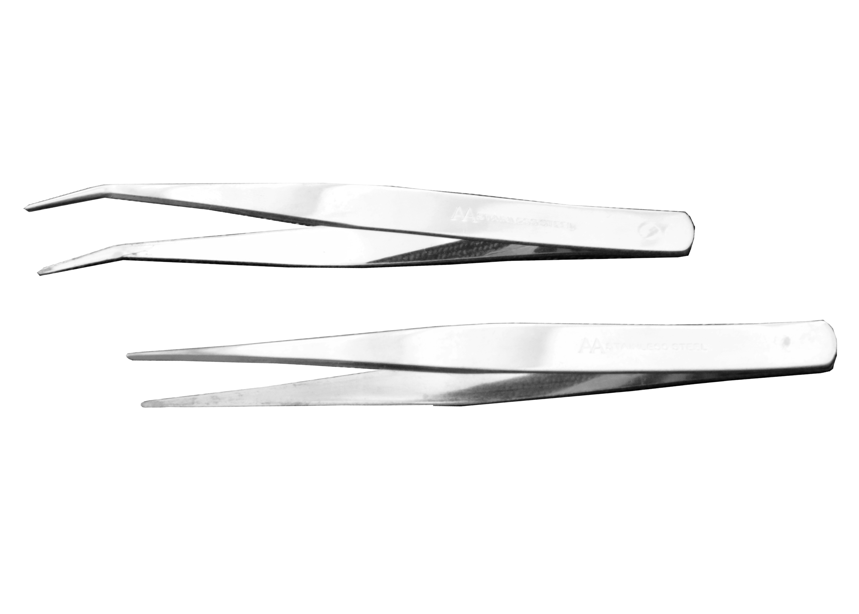
images/Tweezers.jpg
