LIBREhub/2_Levels_Stage/parts/mech/HEX-M3-25.md

---
PartData:
    Specs:
        Type: M3
        Length: 25mm
        Material: Stainless steel
        Tool needed: Spanner
        Supplier:  -[Pernos kim](https://pernos-kim.negocio.site/)
---

# M3 HEX screw

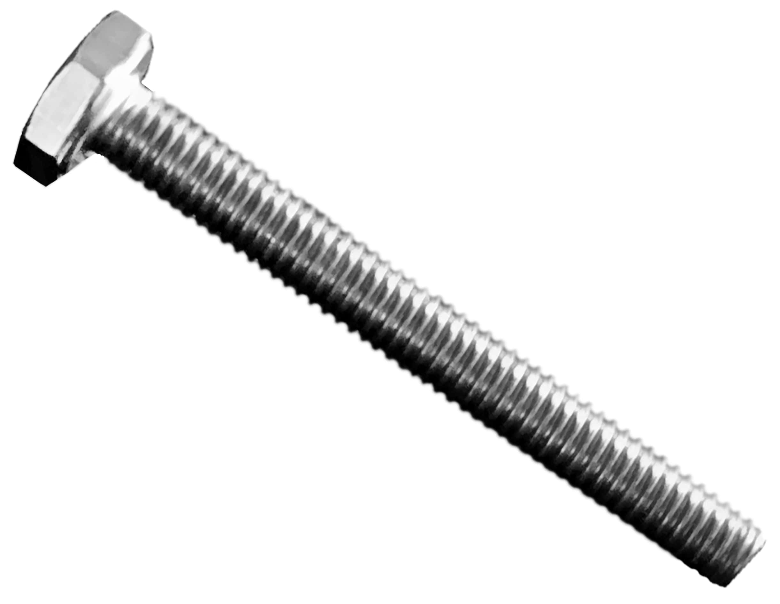
[picture p117: images/torni.jpg]
