LIBREhub/2_Levels_Stage/parts/mech/nuts.md

# Nut

Small hexagonal or square-shaped object with a threaded hole used to fasten objects together. It pairs with a screw.

*Supplier:* [Pernos kim](https://pernos-kim.negocio.site/)
