LIBREhub/2_Levels_Stage/parts/mech/oring.md

# O ring

Elastic ring made of viton with a 34mm. diameter.

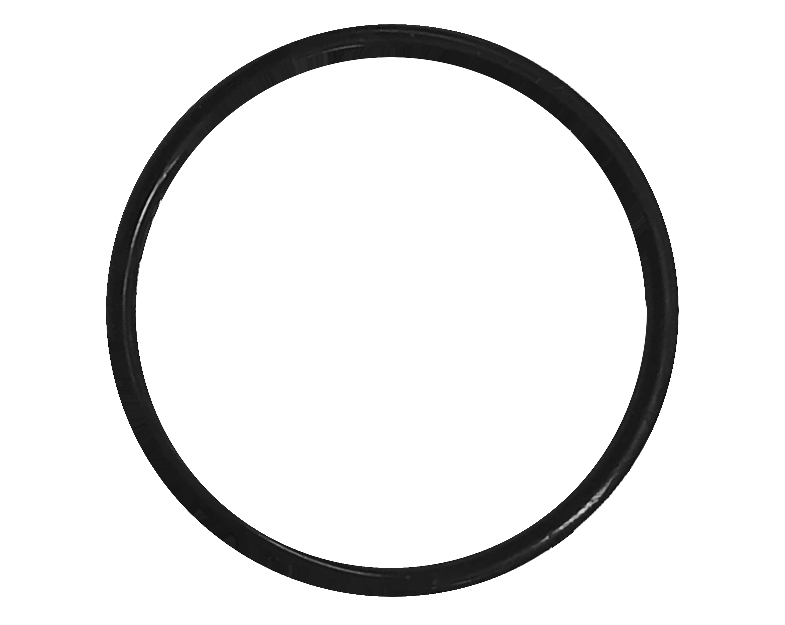
[picture p118: images/oring.jpg]


_Supplier:_ [o-ring stocks](https://www.o-ring-stocks.com/o-ring-34x3-viton-fkm-fpm-90-shore-a-black-orsv2-34x3-fkm89)
