LIBREhub/2_Levels_Stage/images/focus_mechanism_parts.jpg

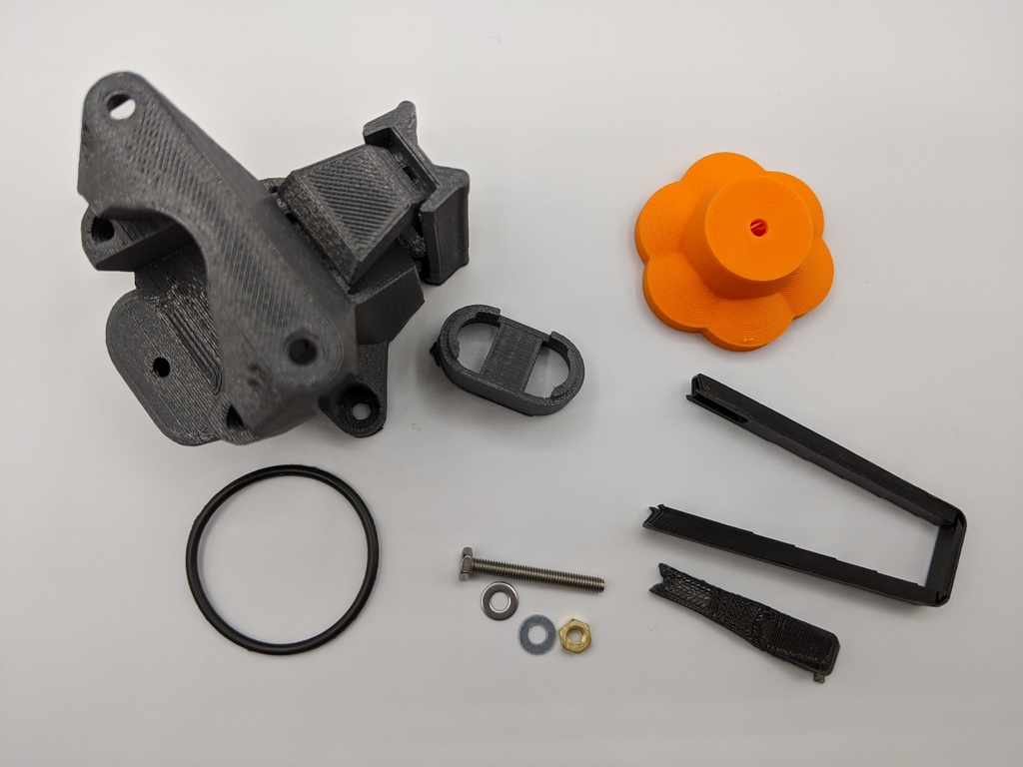
images/focus_mechanism_parts.jpg
