LIBREhub/2_Levels_Stage/parts/materials/laser-cut/bottom-plate-1.png

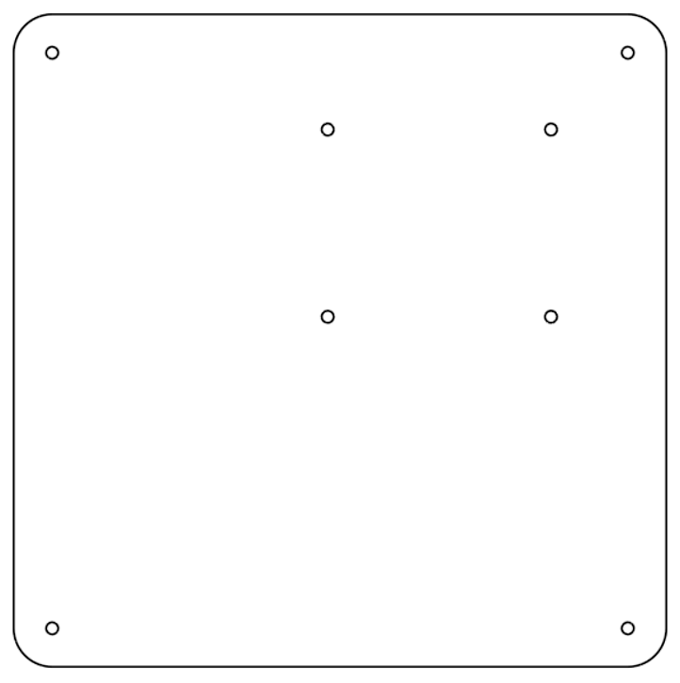
parts/materials/laser-cut/bottom-plate-1.png
