LIBREhub/2_Levels_Stage/parts/materials/laser-cut/middle-plate.png

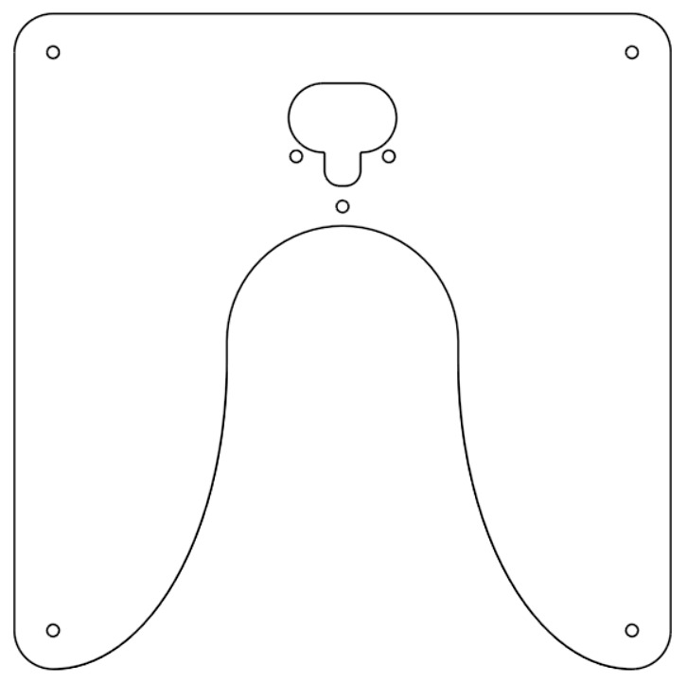
parts/materials/laser-cut/middle-plate.png
