LIBREhub/2_Levels_Stage/parts/materials/laser-cut/top-plate.png

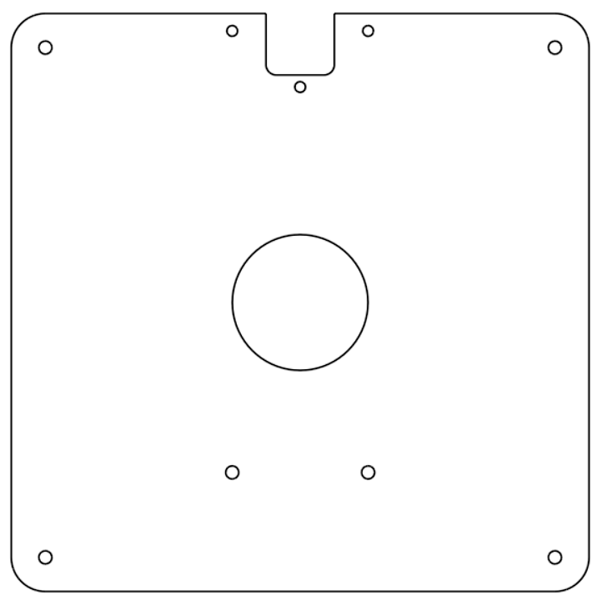
parts/materials/laser-cut/top-plate.png
