LIBREhub/2_Levels_Stage/parts/tools/diagram/AllenKeyBall.png

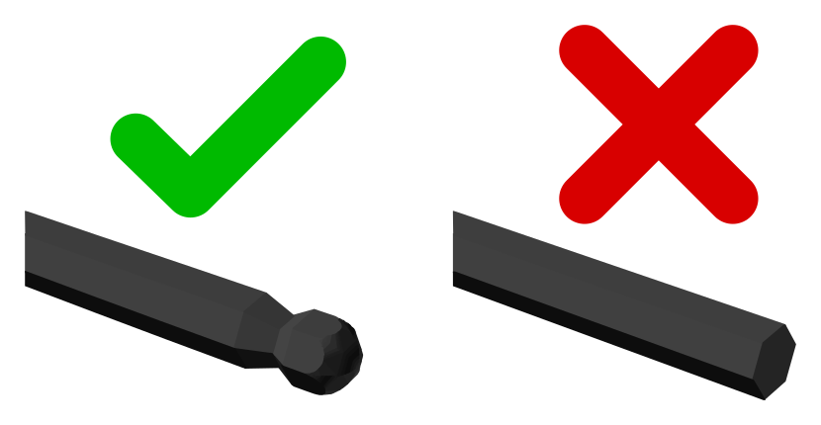
parts/tools/diagram/AllenKeyBall.png
