LIBREhub/2_Levels_Stage/models/actuator-assembly-tools_1.stl

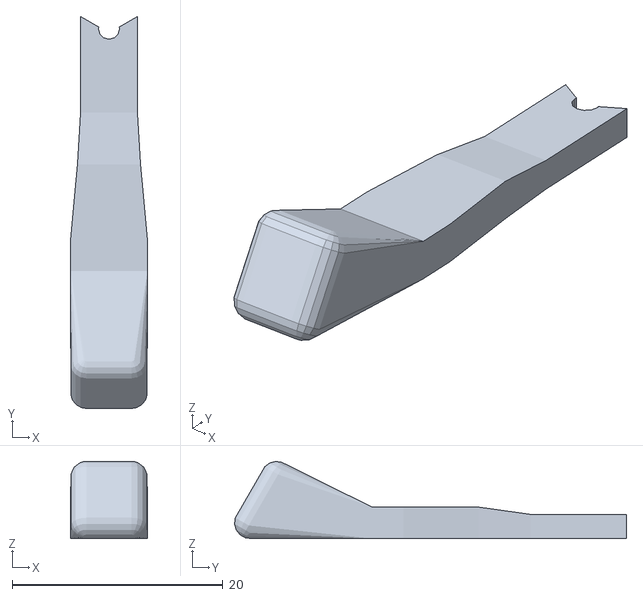
[picture p125: CAD file, 2023-07-06]
models/actuator-assembly-tools_1.stl
7.30 x 37.2 x 7.33
