LIBREhub/2_Levels_Stage/models/focusing-assembly.stl

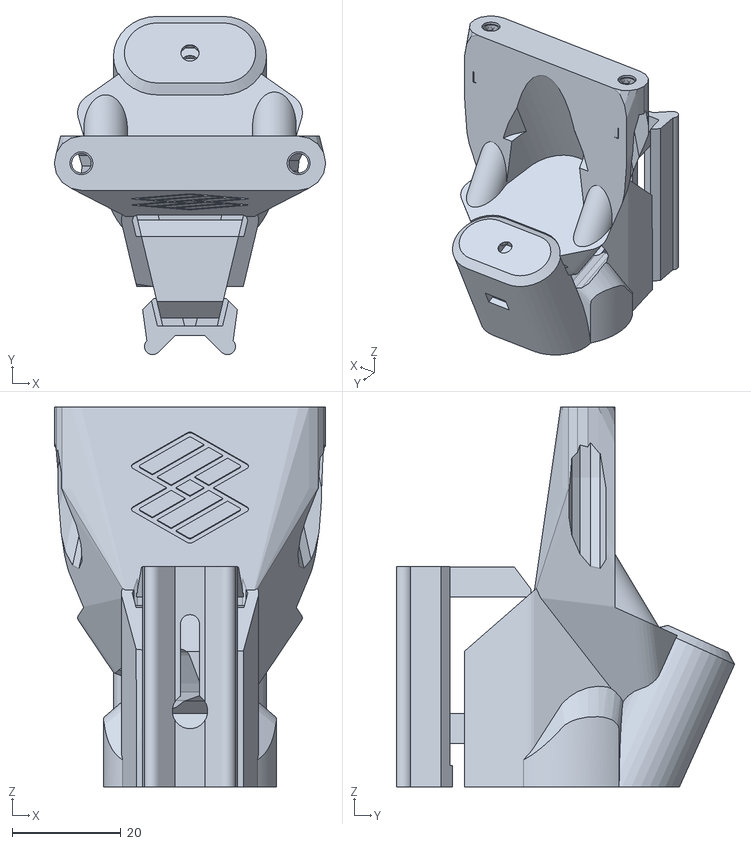
[picture p126: CAD file, 2023-07-06]
models/focusing-assembly.stl
50.0 x 62.3 x 70.0
