LIBREhub/2_Levels_Stage/models/actuator-assembly-tools.stl

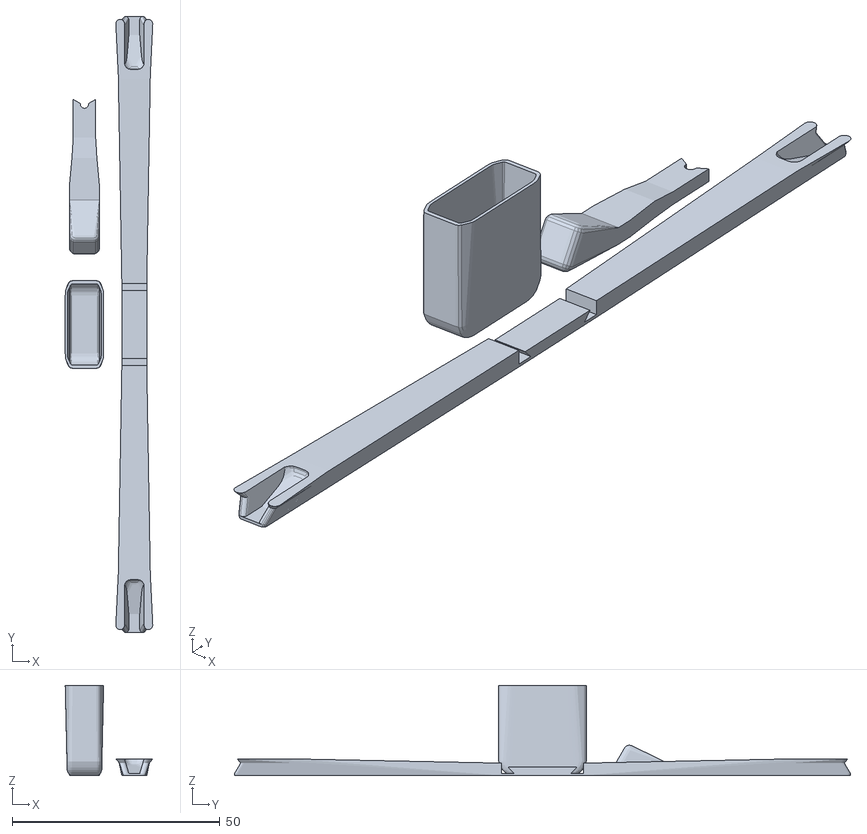
[picture p127: CAD file, 2023-07-06]
models/actuator-assembly-tools.stl
21.1 x 148.2 x 21.7
