LIBREhub/2_Levels_Stage/parts/materials/laser-cut/bottom-plate.dxf

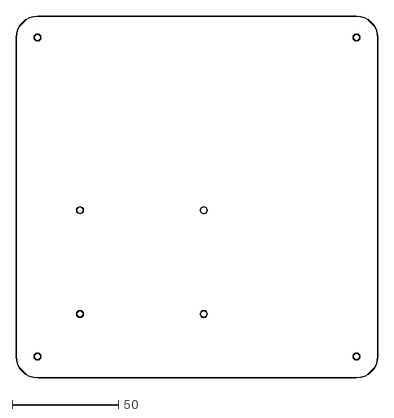
[picture p128: CAD file, 2023-09-12]
parts/materials/laser-cut/bottom-plate.dxf
170.0 x 170.0
