LIBREhub/2_Levels_Stage/models/standoff-S.stl

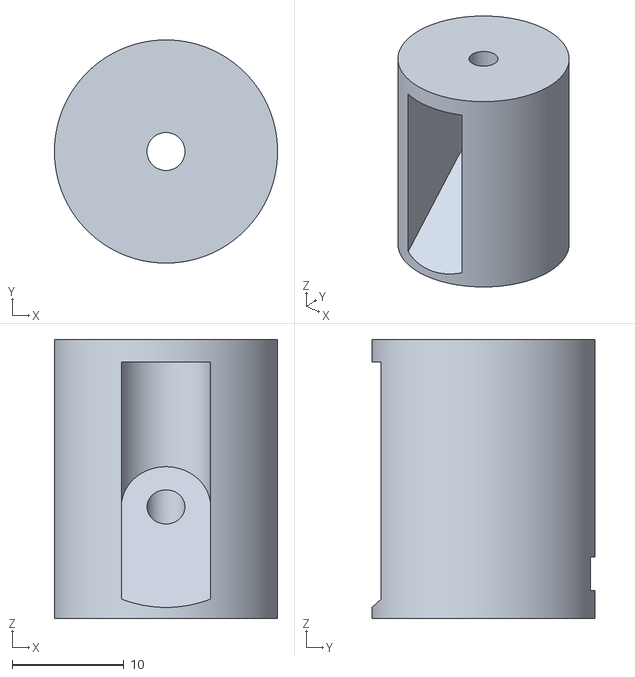
[picture p129: CAD file, 2023-09-12]
models/standoff-S.stl
20.0 x 20.0 x 25.0
