LIBREhub/2_Levels_Stage/parts/materials/laser-cut/middle-plate.dxf

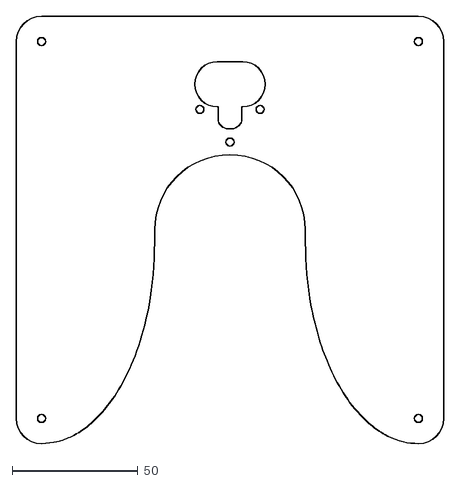
[picture p130: CAD file, 2023-07-06]
parts/materials/laser-cut/middle-plate.dxf
170.0 x 170.0
