LIBREhub/2_Levels_Stage/models/Holders-bottom-plate.stl

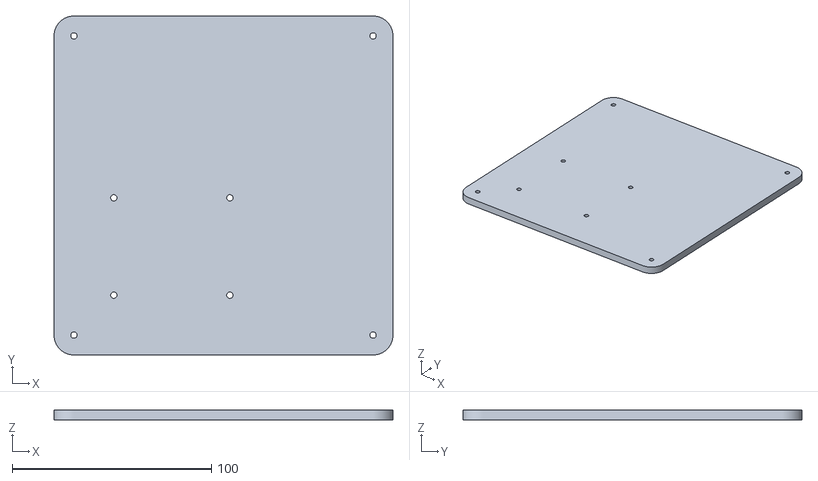
[picture p131: CAD file, 2023-09-12]
models/Holders-bottom-plate.stl
170.0 x 170.0 x 5.00
