LIBREhub/2_Levels_Stage/parts/materials/laser-cut/top-plate.dxf

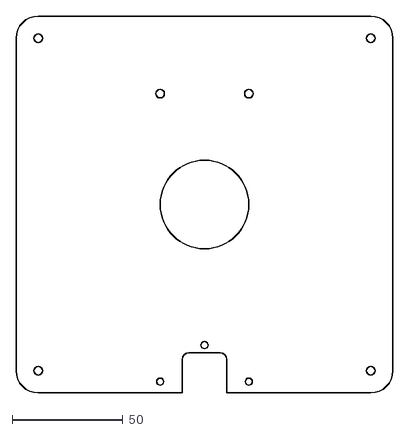
[picture p132: CAD file, 2023-07-06]
parts/materials/laser-cut/top-plate.dxf
170.0 x 170.0
