LIBREhub/2_Levels_Stage/models/3D-Bottom-plate.stl

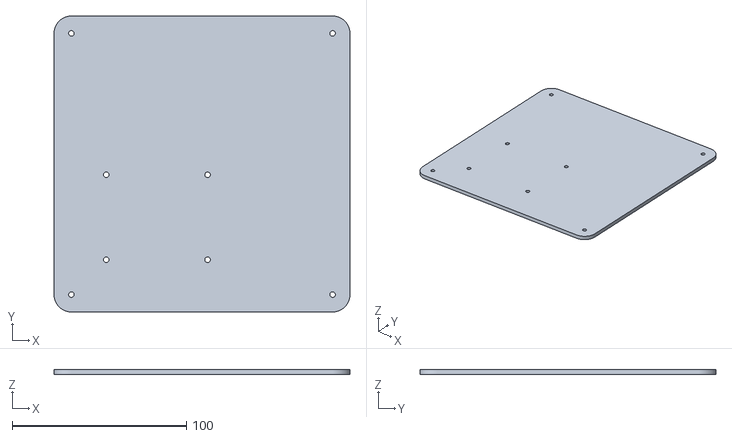
[picture p133: CAD file, 2023-09-12]
models/3D-Bottom-plate.stl
170.0 x 170.0 x 3.00
