LIBREhub/2_Levels_Stage/models/Holders-middle-plate.stl

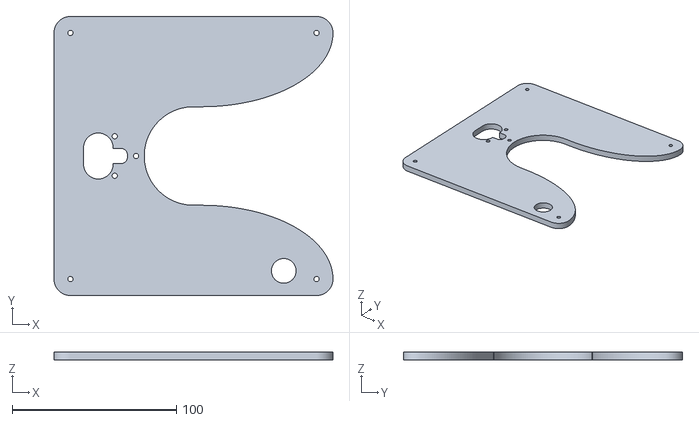
[picture p134: CAD file, 2023-09-12]
models/Holders-middle-plate.stl
170.0 x 170.0 x 5.00
