LIBREhub/2_Levels_Stage/models/Holders-top-plate.stl

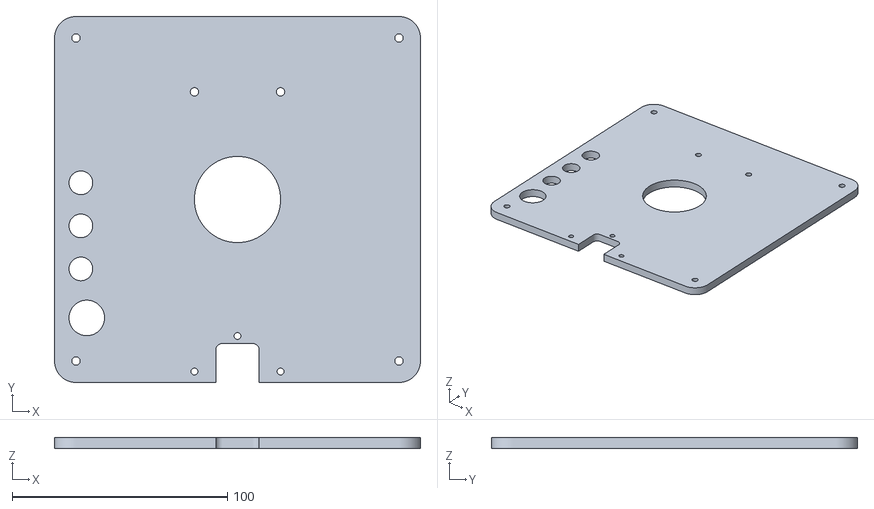
[picture p135: CAD file, 2023-09-12]
models/Holders-top-plate.stl
170.0 x 170.0 x 5.00
