LIBREhub/2_Levels_Stage/models/z_foot.stl

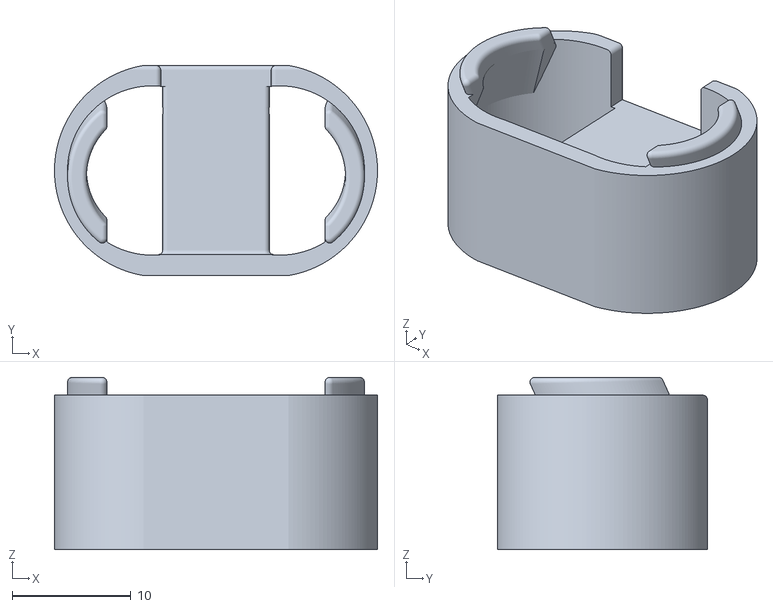
[picture p136: CAD file, 2023-09-12]
models/z_foot.stl
27.2 x 17.7 x 14.5
