LIBREhub/2_Levels_Stage/models/thumbwheel.stl

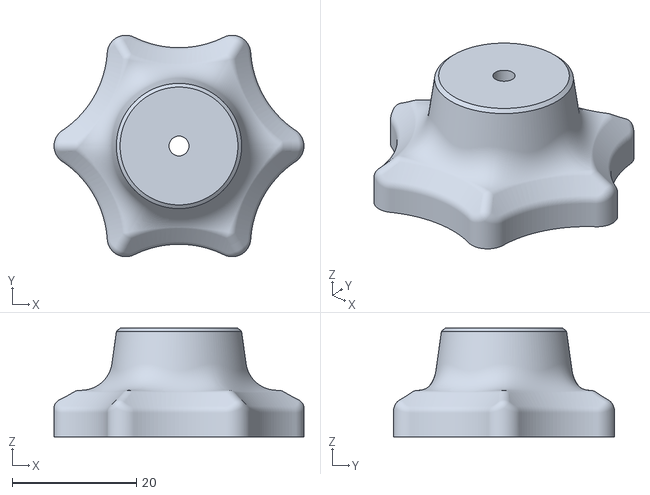
[picture p137: CAD file, 2023-09-12]
models/thumbwheel.stl
40.2 x 35.6 x 17.5
