LIBREhub/2_Levels_Stage/models/foot-M.stl

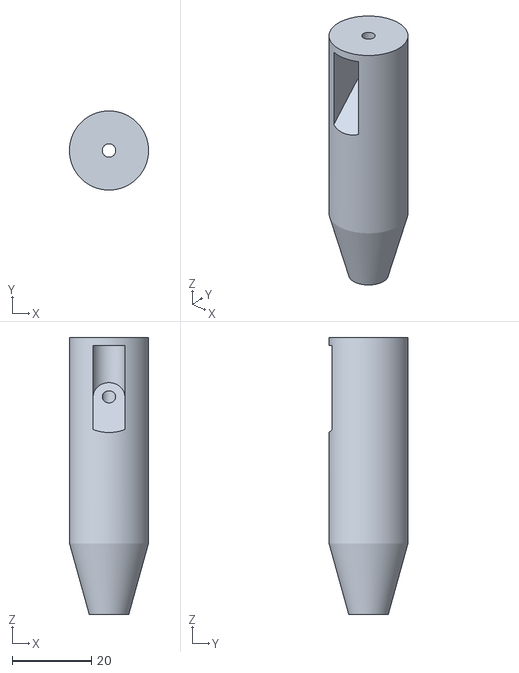
[picture p138: CAD file, 2023-09-12]
models/foot-M.stl
20.0 x 20.0 x 70.0
