LIBREhub/2_Levels_Stage/models/spacer-4mm.stl

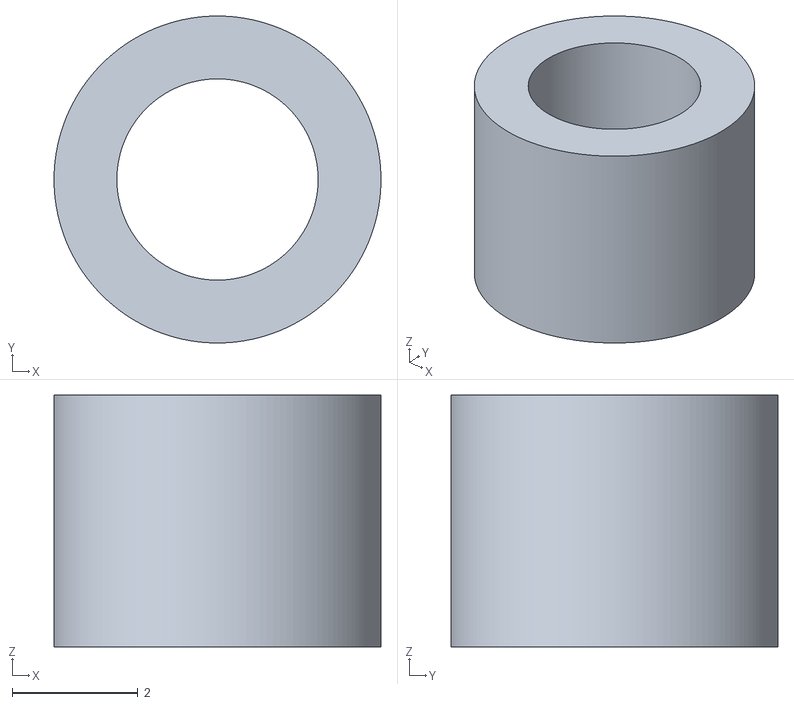
[picture p139: CAD file, 2023-09-12]
models/spacer-4mm.stl
5.20 x 5.20 x 4.00
