LIBREhub/2_Levels_Stage/models/spacer-11mm.stl

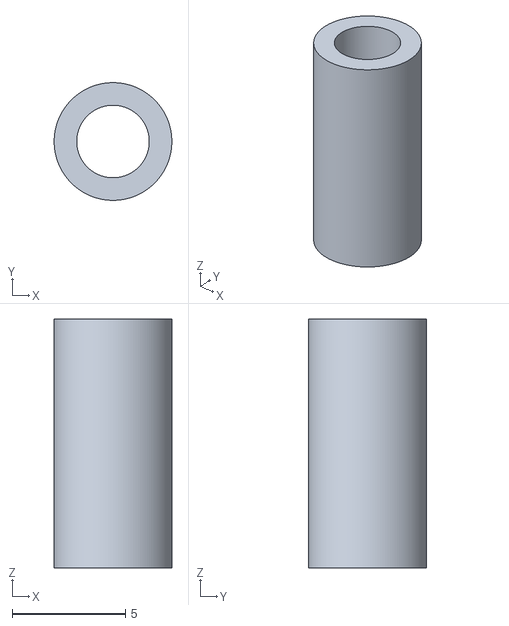
[picture p140: CAD file, 2023-09-12]
models/spacer-11mm.stl
5.20 x 5.20 x 11.0
