LIBREhub/2_Levels_Stage/models/arm-pin.stl

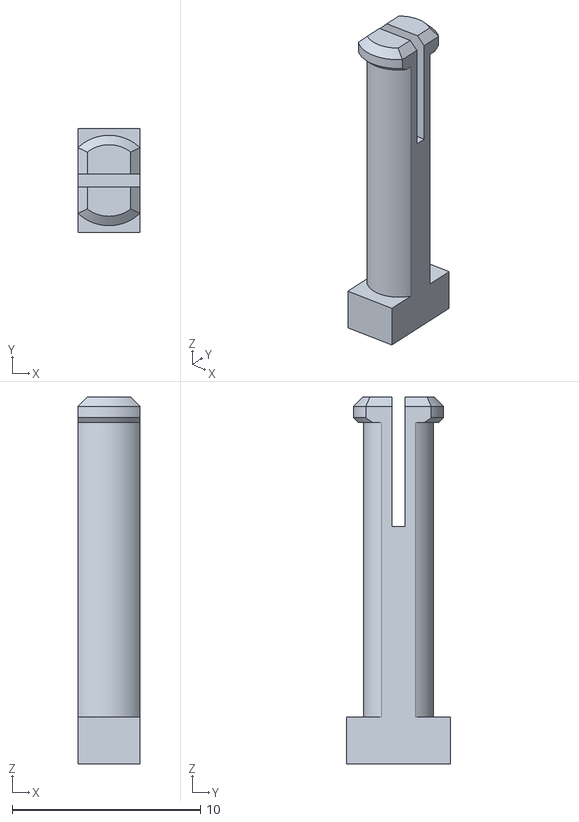
[picture p141: CAD file, 2023-07-06]
models/arm-pin.stl
3.30 x 5.50 x 19.5
