LIBREhub/2_Levels_Stage/models/standoff_S_cone.stl

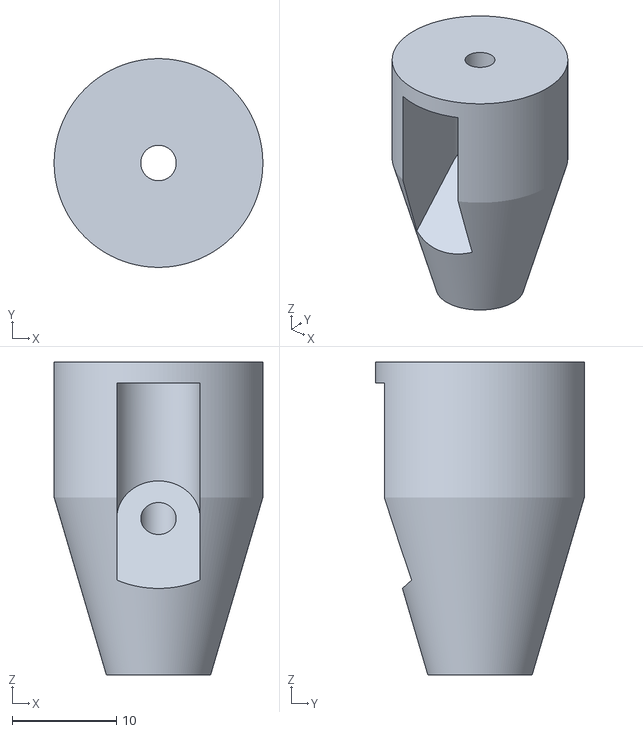
[picture p142: CAD file, 2023-07-06]
models/standoff_S_cone.stl
20.0 x 20.0 x 30.0
