LIBREhub/2_Levels_Stage/models/top-plate.stl

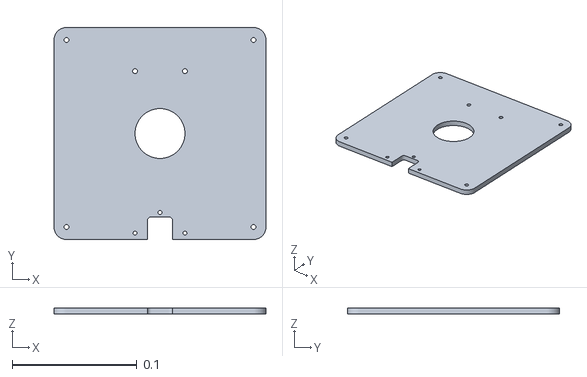
[picture p143: CAD file, 2023-07-06]
models/top-plate.stl
0.17 x 0.17 x 0.005
