LIBREhub/2_Levels_Stage/models/leg_test.stl

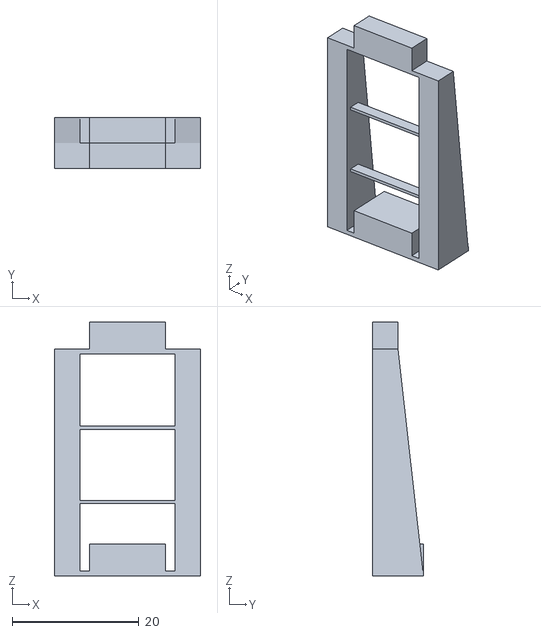
[picture p144: CAD file, 2023-07-06]
models/leg_test.stl
23.0 x 8.00 x 40.0
