LIBREhub/2_Levels_Stage/models/illumination-base.stl

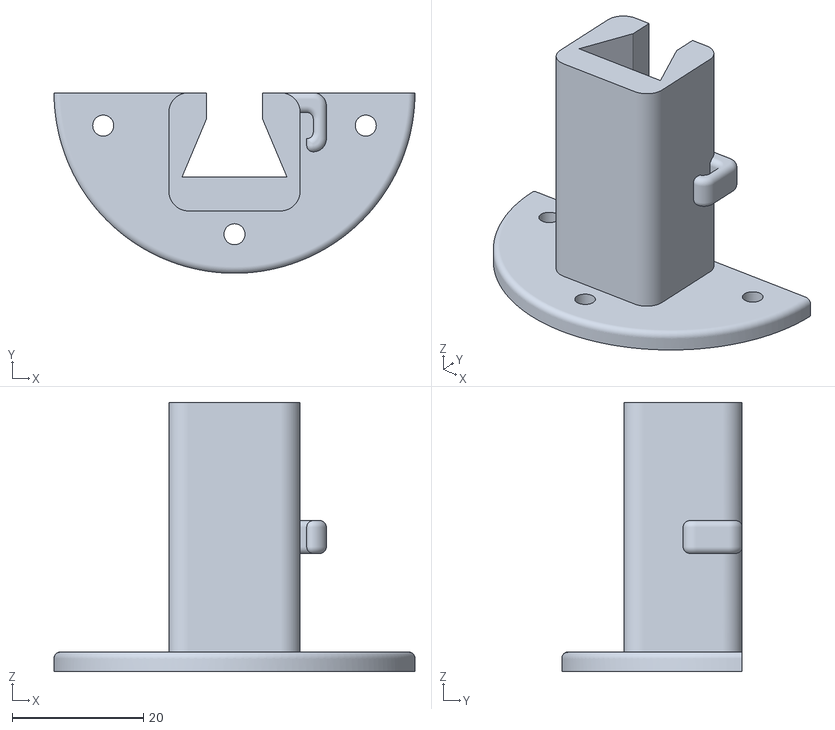
[picture p145: CAD file, 2023-07-06]
models/illumination-base.stl
55.0 x 27.5 x 41.0
