LIBREhub/2_Levels_Stage/models/illumination-slider.stl

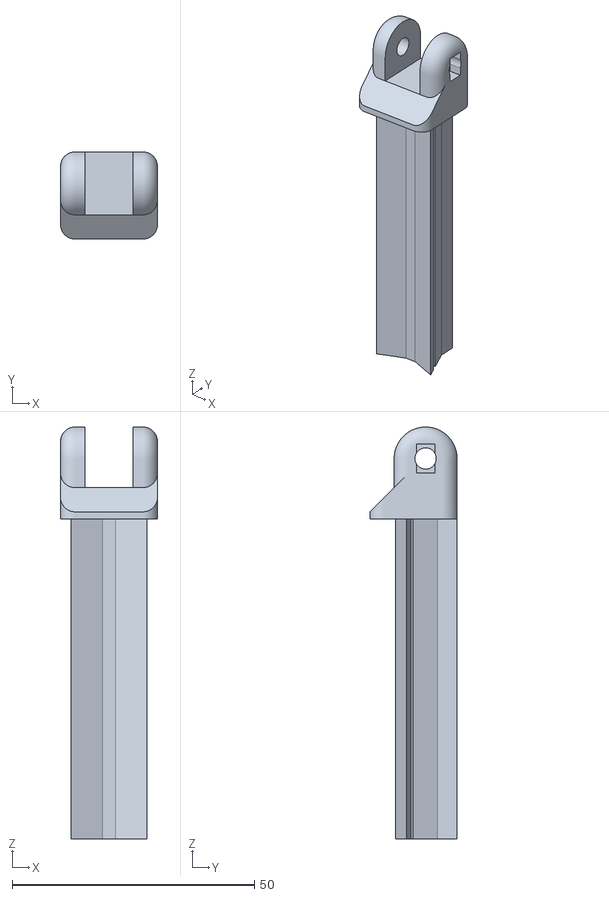
[picture p146: CAD file, 2023-07-06]
models/illumination-slider.stl
20.0 x 18.0 x 85.0
