LIBREhub/2_Levels_Stage/models/camera-platform.stl

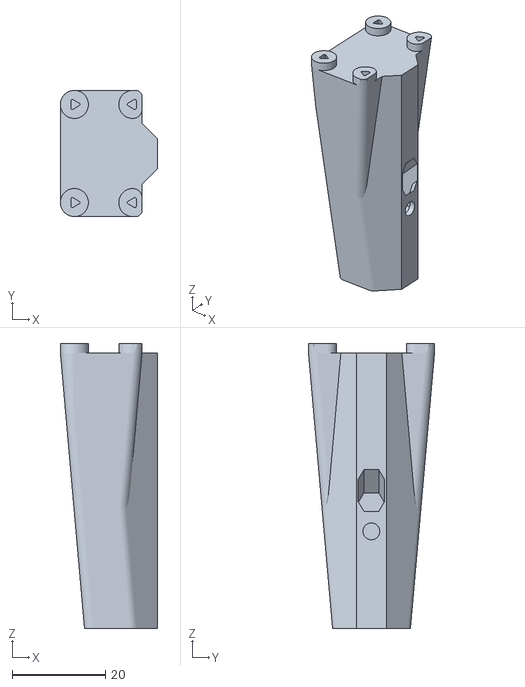
[picture p147: CAD file, 2023-07-06]
models/camera-platform.stl
20.8 x 27.0 x 61.0
