LIBREhub/2_Levels_Stage/models/led-cover.stl

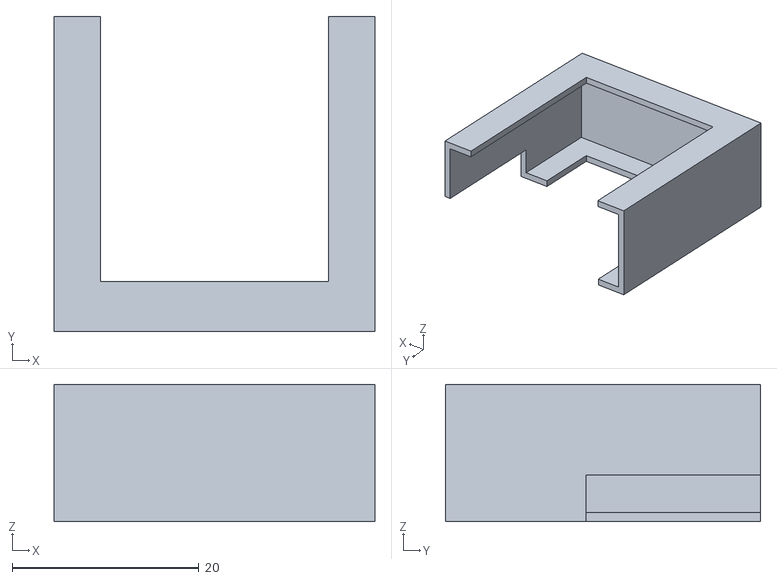
[picture p148: CAD file, 2023-07-06]
models/led-cover.stl
34.4 x 33.8 x 14.7
