LIBREhub/2_Levels_Stage/models/led-arm.stl

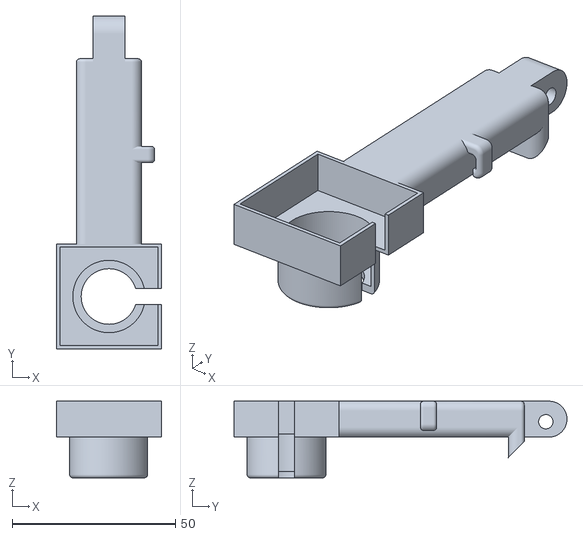
[picture p149: CAD file, 2023-07-06]
models/led-arm.stl
32.2 x 102.1 x 23.5
