LIBREhub/2_Levels_Stage/models/lens-spacer.stl

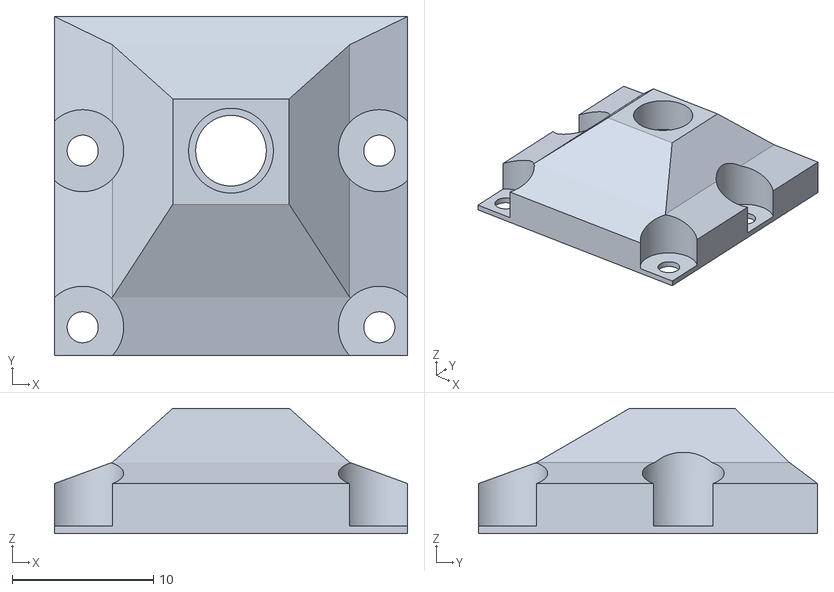
[picture p150: CAD file, 2023-07-06]
models/lens-spacer.stl
25.0 x 24.0 x 8.88
