LIBREhub/2_Levels_Stage/models/standoff-M.stl

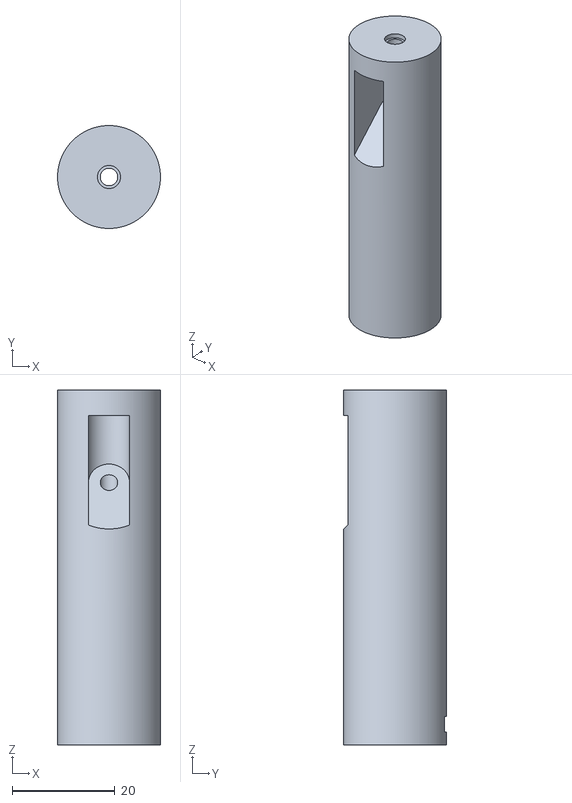
[picture p151: CAD file, 2023-07-06]
models/standoff-M.stl
20.0 x 20.0 x 69.0
