LIBREhub/2_Levels_Stage/models/screencase.stl

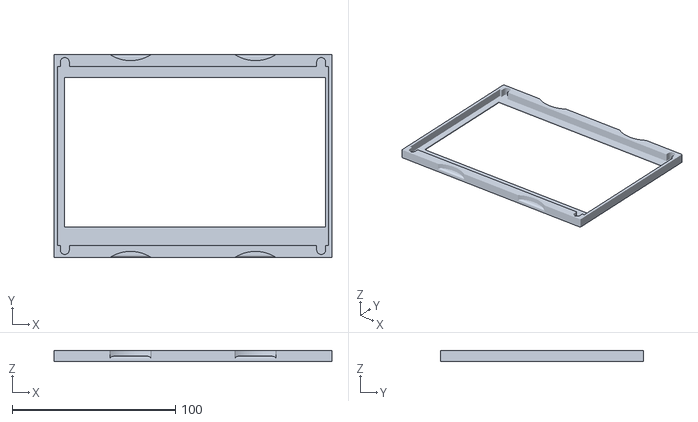
[picture p152: CAD file, 2023-07-06]
models/screencase.stl
170.1 x 124.0 x 6.80
