LIBREhub/2_Levels_Stage/models/screen-base.stl

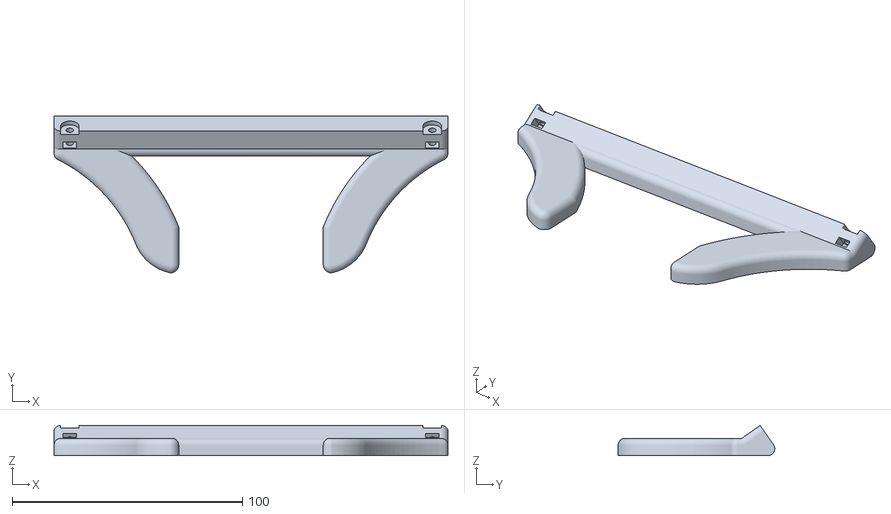
[picture p153: CAD file, 2023-07-06]
models/screen-base.stl
171.0 x 68.0 x 13.1
