LIBREhub/2_Levels_Stage/models/screen-top.stl

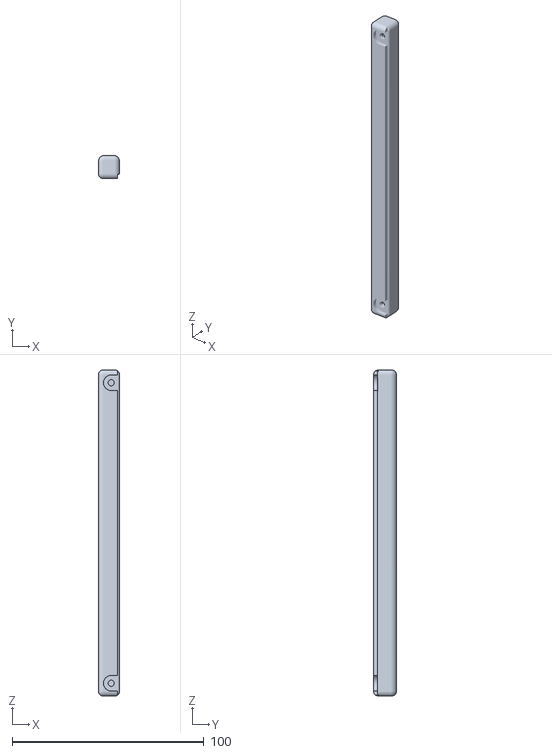
[picture p154: CAD file, 2023-06-09]
models/screen-top.stl
11.0 x 12.0 x 170.0
