LIBREhub/2_Levels_Stage/(list of files, cad)

Other CAD files:
models/middle-plate.stl
models/illumination-thumbscrew.stl
