LIBREhub/2_Levels_Stage/assemble-focus-mechanism.md

# Assemble the focus mechanism

{{BOM}}

[M3x25mm hex head screw]: parts/mech/HEX-M3-25.md "{cat:mechanic}"
[M3 washers]: parts/mech/washer.md "{cat:mechanic}"
[light oil]: parts/consumables/light-oil.md "{cat:consumable, note:'Optional'}"
[M3 nut]: parts/mech/nuts.md "{cat:mechanic}"
[O-ring]: parts/mech/oring.md "{cat:mechanic}"
[Nut tool]: models/actuator-assembly-tools.stl "{previewpage}"
[Band tool]: models/actuator-assembly-tools.stl "{previewpage}"
[Thumbwheel]: models/thumbwheel.stl "{previewpage}"
[Focusing assembly]: models/focusing-assembly.stl "{previewpage}"
[Actuator Foot]: models/z_foot.stl "{previewpage}"
[Tweezers]: parts/tools/tweezers.md "{cat:tool}"

>i **Recomendation** 
>i 
>i Use [tweezers][Tweezers]{Qty:1} to aid in picking up small items such as washers and delicate parts.

## Assemble the thumbwheel {pagestep}

* Push the [M3x25mm hex head screw]{qty:1} into the [thumbwheel][Thumbwheel](fromstep){qty:1, cat:printedpart}.
* Thread the [M3 washers]{qty:2} onto the screw.
* Place a drop of [light oil]{qty:1 drop} on the screw thread. You might want to put some kitchen paper or blu roll on your bench to soak up any dribbles of oil.

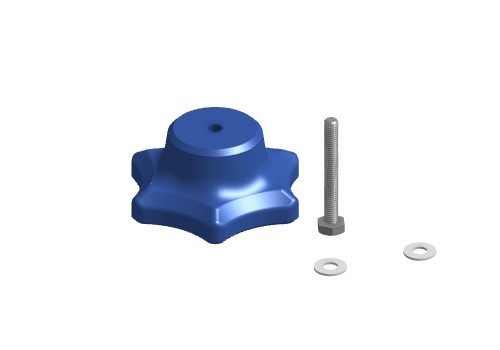
[picture p155: images/thumbwheel_parts.jpg]

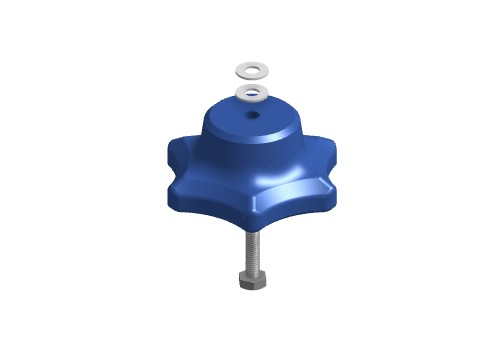
[picture p156: images/thumbwheel_assembled.jpg]

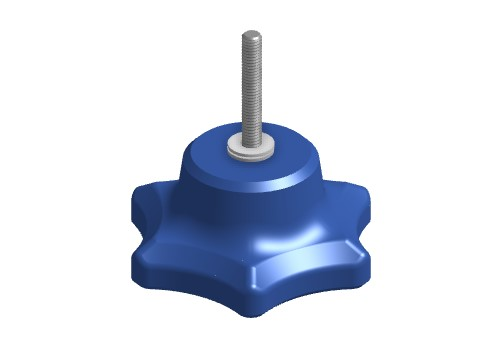
[picture p157: images/thumbwheel_assembled_1.jpg]


## Insert the nut {pagestep}

* Push the [M3 nut]{qty:1} into the slot in the [focusing assembly][Focusing assembly](fromstep){qty:1, cat:printedpart} (using the [nut insertion tool][Nut tool](fromstep){qty:1, cat:printedtool})

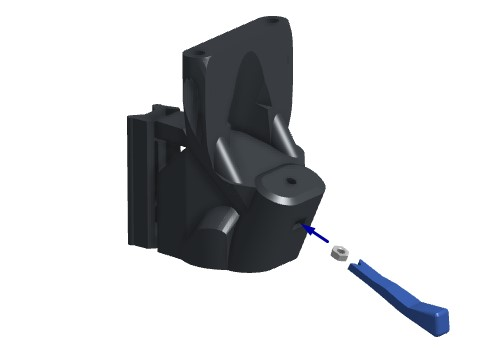
[picture p158: images/nut_insertion.jpg]

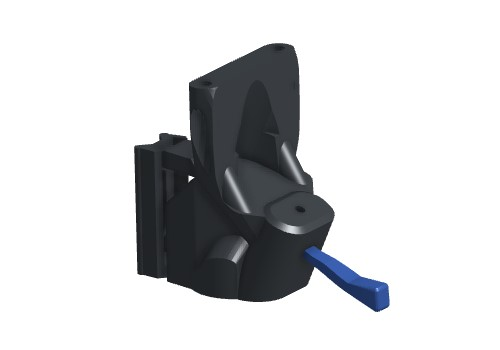
[picture p159: images/nut_inserted.jpg]


## Add the thumbwheel {pagestep}

* Screw the [thumbwheel][Thumbwheel] assembly into the [M3 nut] in the [focusing assembly][Focusing assembly].

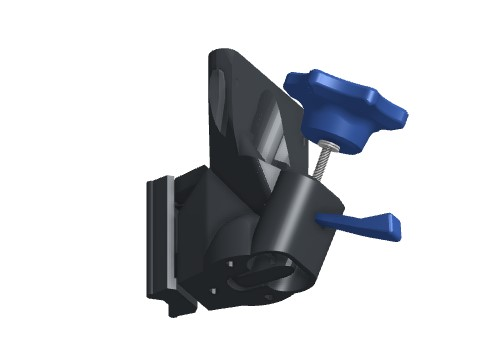
[picture p160: images/thumbwheel_screwed_in.jpg]


## Insert the O ring {pagestep}
Next, we will insert the [O-ring] to complete the mechanism.

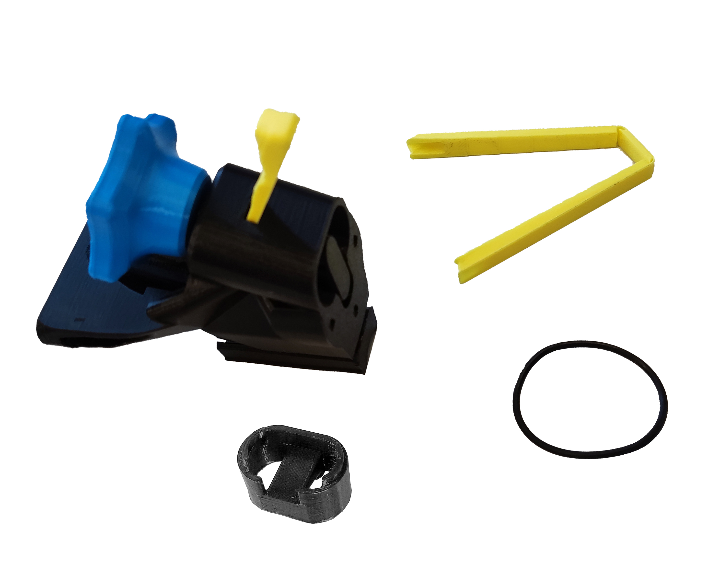
[picture p161: images/band_insertion_parts.jpg]


* Thread the [30mm diameter, 2mm thickness Viton O ring][O-ring]{qty:1} through the two holes in the [foot][Actuator Foot](fromstep){qty:1, cat:printedpart}, and use the [band insertion tool][Band tool](fromstep){qty:1, cat:printedtool} to stretch the two loops of band as shown in the picture.

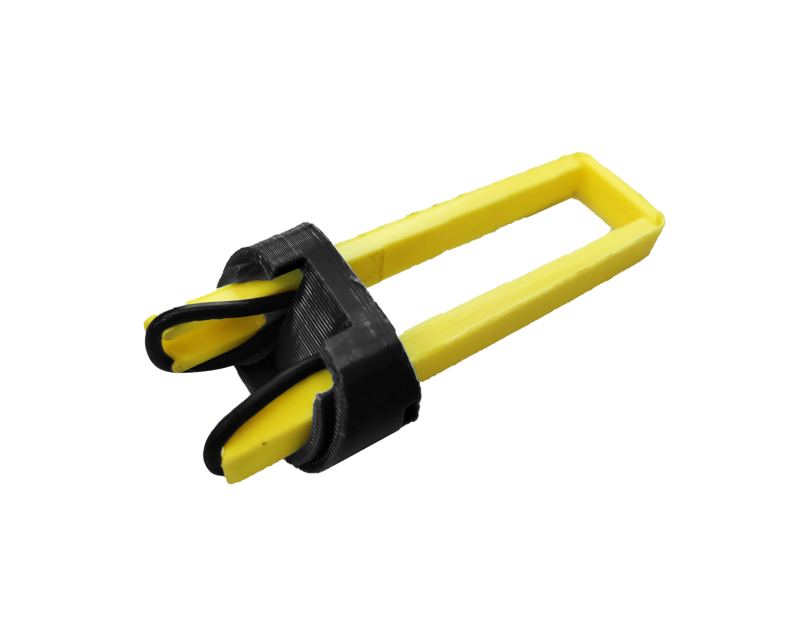
[picture p162: images/band_in_foot.jpg]


## Click the band into place {pagestep}

* Line the [foot][Actuator Foot] up with the hole in the bottom of the [focusing assembly][Focusing assembly], and push on the [band insertion tool][Band tool] to click the band into place.
* You should feel two clicks as the two ends of the band hook over the actuator column. It's easier if you use the [nut insertion tool][Nut tool] to hold the mechanism still as you do this.

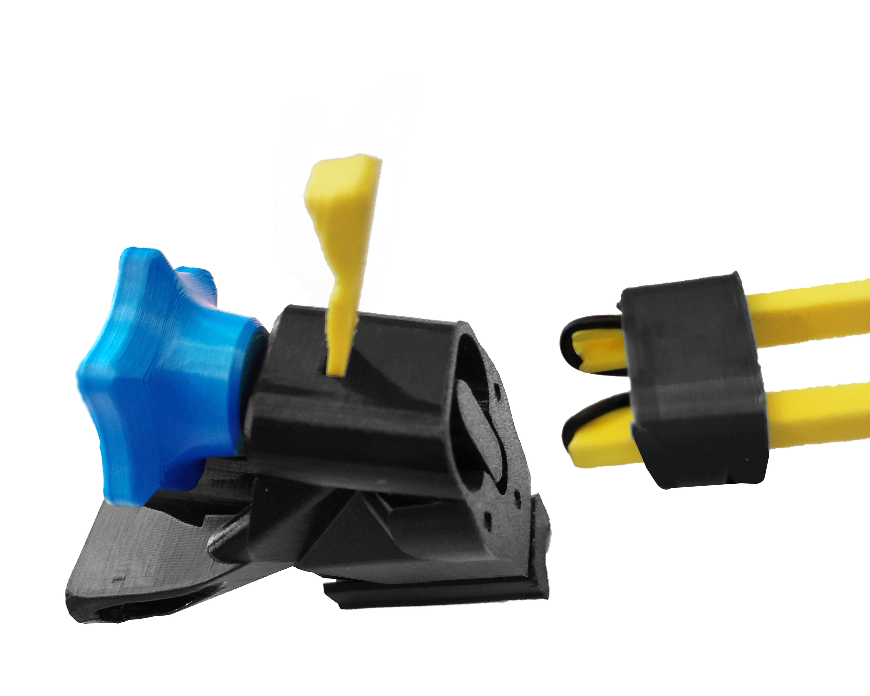
[picture p163: images/band_insertion_1.jpg]

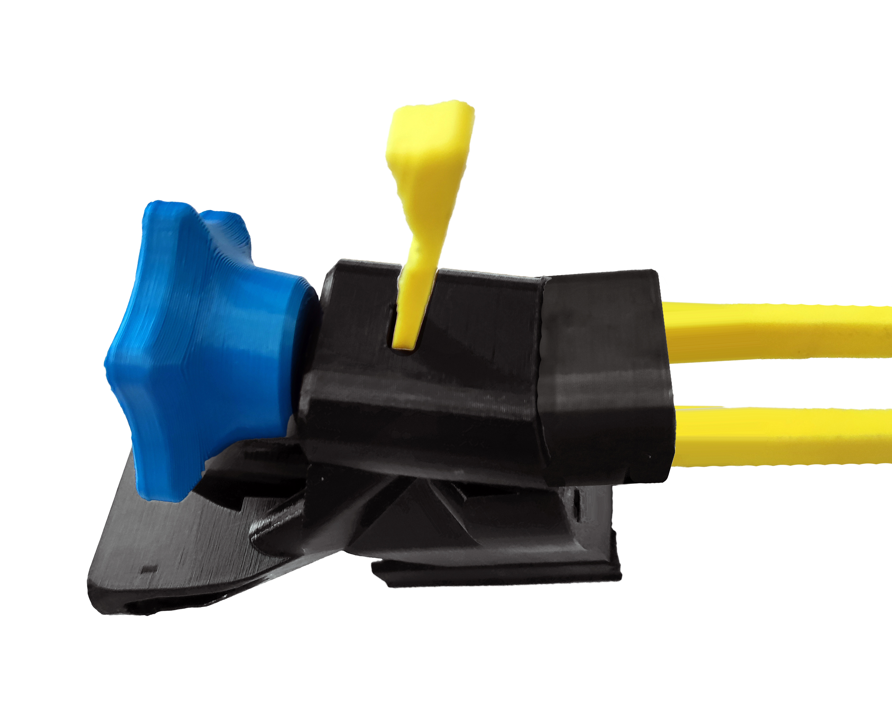
[picture p164: images/band_insertion_2.jpg]

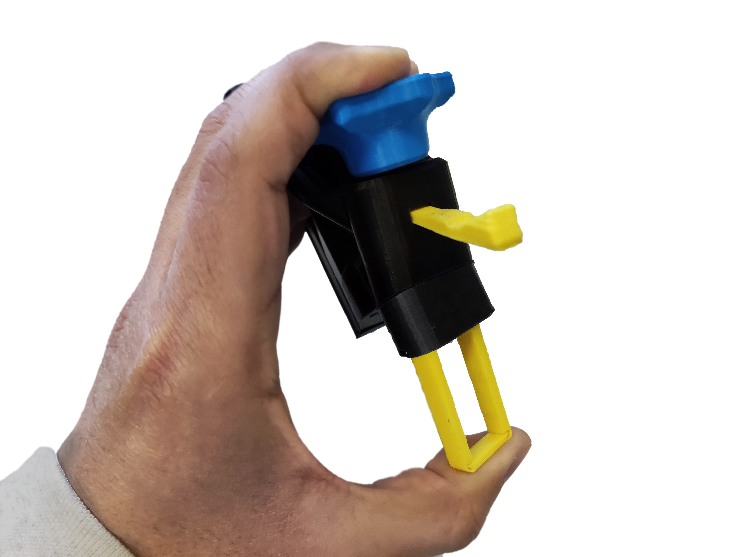
[picture p165: images/band_insertion_3.jpg]

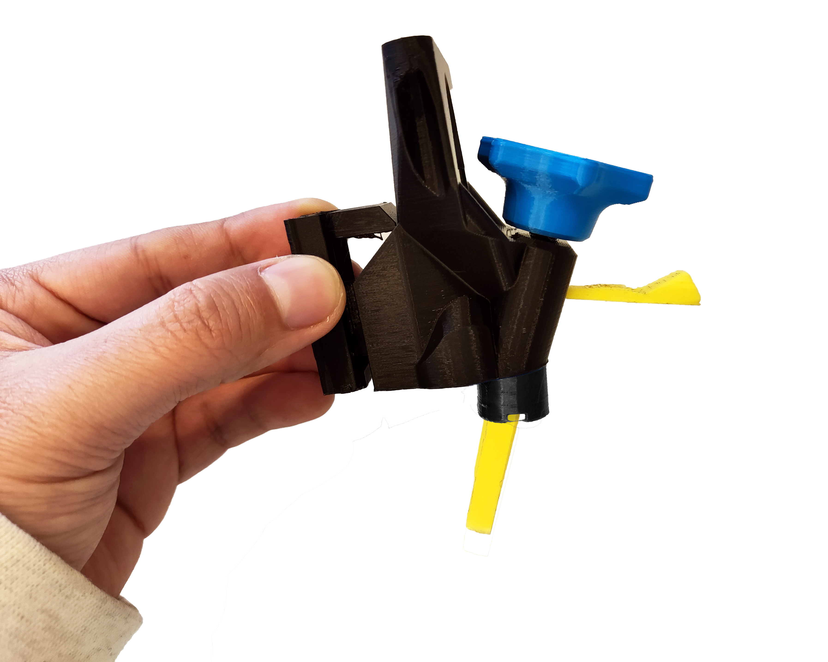
[picture p166: images/band_insertion_4.jpg]


## Remove the tool {pagestep}

* Gently pull the [band insertion tool][Band tool] out of the [foot][Actuator Foot].
* The band should pull the foot tight against the [focusing assembly][Focusing assembly] as shown.

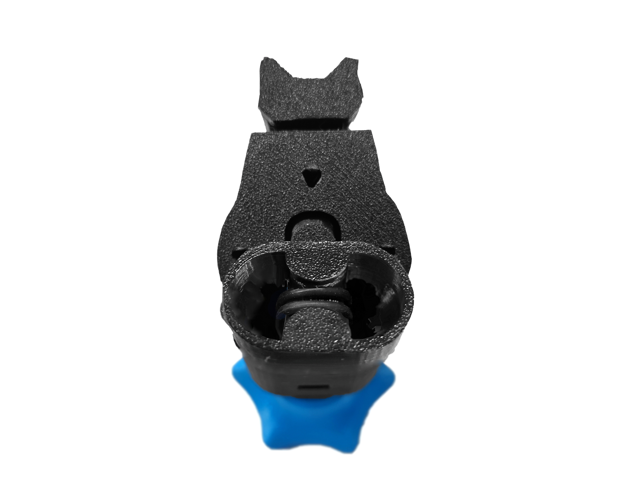
[picture p167: images/band_inserted.jpg]


Well done, you have now assembled the [focusing mechanism]{output, qty:1}.
