LIBREhub/2_Levels_Stage/usage.md

# Use your Station

Find more about the station on the [GitHub repository](https://github.com/wenzel-lab/open-microfluidics-workstation/).

>i **Please Note:** This site is under construction.
