LIBREhub/2_Levels_Stage/images/low_cost_optics_assembly_ribbon.png

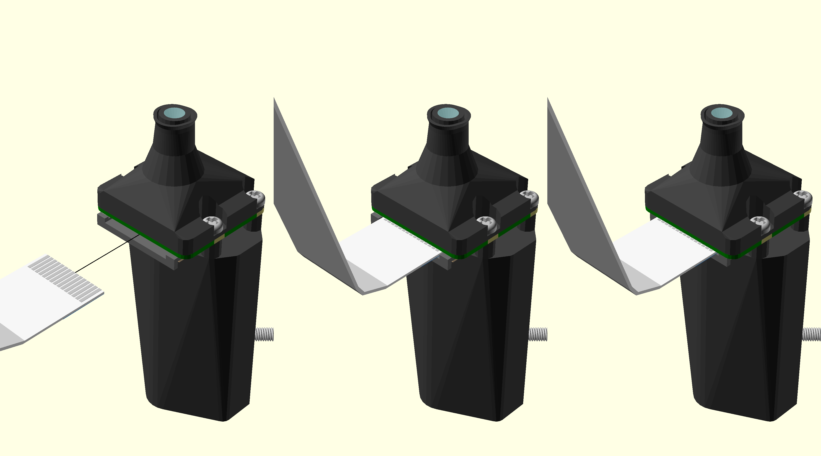
images/low_cost_optics_assembly_ribbon.png
