LIBREhub/2_Levels_Stage/images/PI-hat-guide.jpg

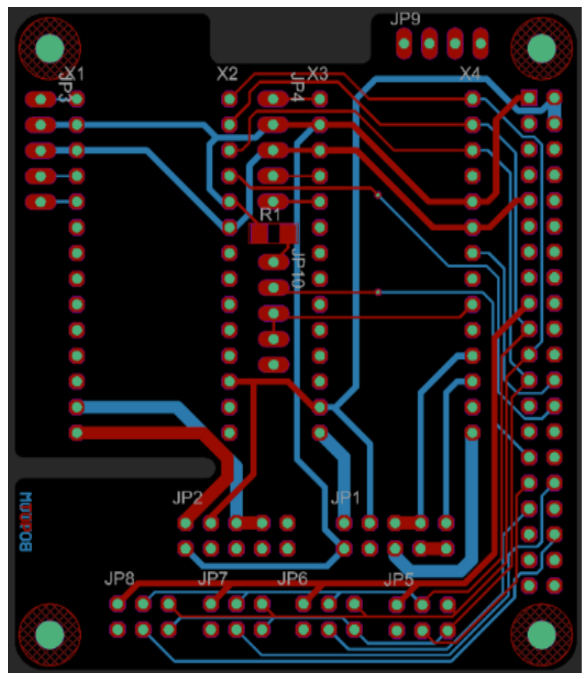
images/PI-hat-guide.jpg
