LIBREhub/2_Levels_Stage/parts/materials/laser-cut/test-matrix.jpg

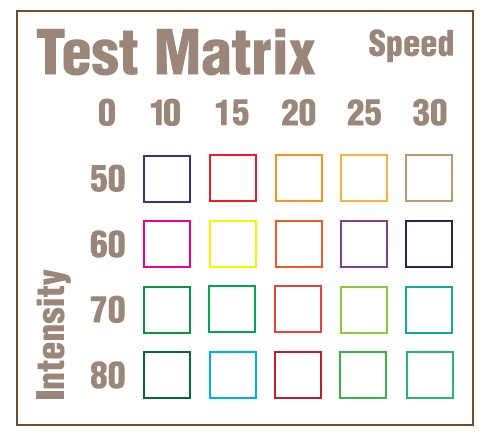
parts/materials/laser-cut/test-matrix.jpg
