LIBREhub/2_Levels_Stage/(commit log)

2023-06-09 Deploying to main from @ c116dcc1f2f277c55dd630f3ddf1102892902a48 🚀
2023-06-09 Deploying to main from @ 748b93a2d2e9b85a752ed8e7267489a5263329fc 🚀
2023-06-09 Deploying to main from @ 69bf8fdffeed028f3128e8d5d7b8d955258824c4 🚀
2023-06-09 Deploying to main from @ a5ce2a9c1f44bf0ae843146a5e4be8587d4e2cab 🚀
2023-07-06 Documentation V2
    [actuator-assembly-tools.stl, actuator-assembly-tools_1.stl, arm-pin.stl, bottom-plate.dxf, bottom-plate.stl, camera-platform.stl, focusing-assembly.stl, foot.stl]
2023-07-06 Deploying to main from @ d45ac56bc95ca066cc260467b850fbae0132b095 🚀
    [2-level-station_BOM.csv]
2023-07-31 Deploying to main from @ 7ab878b3a5eb209a59fb81fe5bb70fad3b9456e4 🚀
2023-09-12 update
    update
    [3D-Bottom-plate.stl, Holders-bottom-plate.stl, Holders-middle-plate.stl, Holders-top-plate.stl, bottom-plate.dxf, foot-M.stl, middle-plate.dxf, middle-plate.stl]
2023-09-12 Deploying to main from @ 1937740644d094d80fcf24f3e44c37f843356d8c 🚀
    [2-level-station_BOM.csv]
2023-09-12 Deploying to main from @ ad71003863697a256cb3f0377ea09aa3e97134fa 🚀
    [2-level-station_BOM.csv]
2023-09-12 Deploying to main from @ 79a747714eb2299edfcc5555907af695f3bff292 🚀
2023-09-12 Deploying to main from @ 9a644a1ab3d21a96555c0fa1fa8ceadcadfc55a8 🚀
2023-11-30 Deploying to main from @ 05a00af25e07babf076e8d216758ea3605378fb9 🚀
